zredlined/esp32-race-logger-enclosure/mechanical/reference/waveshare-7b/dimensions.md

# Waveshare ESP32-S3-Touch-LCD-7B (touch version) — measured from ESP32-S3-Touch-LCD-7B.stp, 2026-09-12

STEP frame: X = width (192.96), Z = height (110.76), Y = thickness, +Y toward the viewer. Glass face at Y = +0.8.

| Item | Value |
|---|---|
| Cover glass (lens OD) | 192.96 x 110.76, corners R7.88, X -96.48..96.48, Z -54.36..56.40 |
| Active area | 154.88 x 86.72 (long-edge borders 19.04 each; short-edge borders 11.00 and 13.04) |
| LCD metal frame (back) | 165.4 x 97.6, X -81.05..84.35, Z -46.42..51.18, back face at Y = -7.7 |
| Glass face to frame back | 8.5 (TP + LCD = 5.0) |
| PCB | 106.0 x 73.0 x 1.6, X -55.09..50.93, Z -46.22..26.79, Y -9.3..-7.7 (front face against frame back) |
| Tallest rear parts | terminal blocks 8.3 below PCB back (X 45.4..50.4, Z -23.0..23.9); total glass face to tallest part 18.4 |
| Mounting | 4 x M3 threaded lugs on the frame back, 15 x 8 mm pads, centers X -61.6 / +64.6, Z -32.8 / +32.9 (126.2 x 65.7 pattern); STEP shows the hole 1.7 deep but an M3 screw goes in about 3 mm (measured 2026-09-13) |
| PCB-to-frame screws | 4 x 4.3 mm holes at X -22.5 / 35.5, Z -27.0 / 22.1 (58.0 x 49.05); not for external use |
| USB-C | on the PCB -Z edge, X 10.3..19.3 (center 14.8), body 9 x 5.6 |
| PH2.0 / small headers on -Z edge | X -10.0..-3.9 and 1.1..7.2 |
| ESP32-S3 module | X -52.7..-34.7, Z -46.3..-20.8 (antenna at the -Z edge, -X corner) |

Source: https://www.waveshare.com/wiki/ESP32-S3-Touch-LCD-7B (drawing zip and schematic downloaded 2026-09-12).
