zredlined/esp32-race-logger-enclosure/docs/inspection-log.md

# Inspection log

## Pass 1 (2026-09-09), first full model in Onshape
Source: mechanical/generate_onshape.py -> Onshape Part Studio 1 (custom FeatureScript feature) -> STL -> mechanical/output/renders.
Clearance report: clean (plugs, cables, posts, standoffs, chute, ribs vs boards and each other). Cable table: C1 139/200, C2 73/100, C3 70/100 mm.

Found in renders and fixed in the generator:
- Saddle-to-sled inserts S1 (14,17) and S2 (60,62) sat inside the cradle block footprint, so the bores were buried and the inserts could never be installed. Moved to (27,13) and (W-4, 52.5), outside the block, still clear of cables and posts.
- SHT41 floor vent was blocked by the solid cradle block under the sled. Vent now passes through the plate and the block into the tube cavity.
- Section renders looked at the discarded side of the cut plane (render bug, not geometry).
- FeatureScript: `box` is a reserved word (compile error); the intersection op dropped body identity for the clamp cap (rebuilt with subtract + union).

Checked and OK: every through hole visible from both faces (sled bottom: 4 counterbored shell-screw holes, 2 saddle-screw holes, vent, 4 foot recesses; saddle bottom: 4 access holes, 2 insert bosses, 4 ear bores); flexure flaps 1.0 mm with 0.7 mm slots and 2.2 mm nubs; USB opening with 1 mm lead-in; IMU ledge and two snap hooks; cable ribs; posts clear of the stack; roof chamfer and 5 mm vertical fillets form one family; orange sled band is the only accent.

Open (documented, not fixed): reset button has no roof hole (it would merge with the window edge; shell off in 4 screws); microSD card end sits ~4 mm inside the wall (user says SD access is optional).

## Pass 2 (2026-09-09), Gate C panel (industrial design, FDM, wiring/RF/thermal, red team) on the pass-1 renders
Blocks found and fixed: saddle S1/S2 bores did not pass through the plate (now bored from the plate top); shell and cap screws bottomed in 5 mm bores before the heads seated (post bores 7.5, ear bores 9.0); post P3's screw sat 5 mm above the roll bar (P3 is now a bearing pad, 3 shell screws); key-bar 0.5 mm top recess was an overhang on the bed face and adjacent slots had 0.05 mm slivers (flaps now flush, 0.6 mm thick, 10 mm long, 0.8 mm slots, nub gap 0.1); forward chevron pointed backward on roof and sled (rotation sign).
Fix-before-print applied: louver tops on the SD slot datum (5 + 4 slots, plus 3 back-wall chimney slots over the ESP32); SHT41 vent moved beside the cradle block so it reaches free air; clamp bore 0.3 under the liner radius with cap flanges 1 mm open (real preload); C1 dives to the floor after its corner and runs in an 8 mm wall channel, middle-lane channel rib 8 mm; chute 0.3 from the wall, back margin +0.5 for post P4; pilot holes 2.2 / 1.75, 1.5 mm deeper; IMU hook lips 1.2 mm overlap at +0.05; window inner pocket for a 1 mm PC sheet; reset pin hole; 1.5 mm radii on USB/SD openings; saddle plate inset to the shell footprint (orange band is the outermost lower edge); cradle and cap 5 mm fillets; sled and saddle 0.5 mm bed chamfers; GPS square aligned to the window edge; A/B/C dots; nylon M2 screws at the Feather antenna end (hardware note); test coupon part added.
Deferred: round two-ear collar instead of the block cradle (ID nice-to-have); SD thumb scallop; tie-down bridges (channels + glue instead); satellite glyph.
Pass-2 renders read clean: through holes visible both faces, no slivers, flaps and nubs correct, louvers on one datum, chevron forward.

## Pass 3 (2026-09-09): added the blanked drop slot for a future analog bay and the Universal base (GoPro 3-finger) as the v1 mount. Clearance clean. Renders checked: fingers round-ended and centred, strap slots clear of access holes and inserts.

## Pass 4 (2026-09-11): the "floating GoPro mount"
The user saw the base fingers floating in Onshape. Cause: fingers, cradle and insert bosses overlapped their plates by only 0.01 mm, and Onshape did not fuse them, so the base and saddle each exported as two bodies. Fix: 1.0 mm overlap into the plate. The exporter now loads each STL and fails unless it is one manifold body. All six parts pass.

## Pass 5 (2026-09-12): stack height corrected from hardware
User measured 27.0 mm from the Feather PCB bottom to the OLED PCB top with the real 2830 stacking headers (6.9 mm body, 11.4 mm tails, 12.7 mm pitch per level). The model assumed 8.5 mm sockets (21.7 mm). STACK_PITCH = 12.7 added; everything above the Feather re-derives: interior height 29.3 -> 34.6, roof top 36.6, SD slot z 16.3-22.3, louver tops on the new SD datum, chimney slots 22.3-32.1, OLED QT exit 26.4-29.4, key nubs and window follow. Clearance clean. Note added: trim the Feather's bottom header tails to <= 3 mm.

## Pass 6 (2026-09-12): coupon results applied
Insert bore 3.4 (tight, melted flush, no gaps under magnification; 3.6 marginal; 3.8 fell in). M2.5 self-tap best in 2.4 (2.2 too tight). Keys: all three click the OLED Wing buttons, slots printed open. M2 not tested (no screws on hand); pilot scaled to 1.9. Constants updated, regenerated, assemblies rebuilt, STLs re-exported (all one manifold body).

## Pass 7 (2026-09-12): button cap height measured
User measured 4.0 mm from the OLED Wing PCB bottom to the button cap top (2.43 above PCB top; model had 1.9). With the old value the key nubs would have held the buttons half-pressed. Z_BTN_TOP now derives from the measurement; nubs are 2.55 mm tall, 0.1 above the caps; caps clear the roof underside by 1.2 mm. Shell re-exported (one manifold body), assemblies rebuilt. Base and sled unchanged.

## Pass 8 (2026-09-12): stack tolerance
Assembled stack eyeballed at just under 30 mm Feather-PCB-bottom to cap top vs 29.4 from summed measurements. Design now uses 29.7 with 0.3 mm nub clearance (covers 29.4 to 30.0 without pre-pressing) and the roof underside at glass + 2.1 (35.1) so a tall stack keeps >= 1 mm over the caps. Nubs 2.25 mm. Shell re-exported; base and sled unchanged. If keys feel pre-pressed after assembly, sand the nubs; if dead, a dot of glue on the nub tip.

## Pass 9 (2026-09-13): first assembled prototype feedback
User assembled v1. Findings and fixes: IMU hook lips printed flush with the PCB top (0.05 design gap) so the board could not wedge under; lips now 0.35 above the PCB with a 0.7 mm 45-degree lead-in and taller posts. Keys work well. Reset pin hole replaced by a round flexure key (r 1.9, stem toward the back wall, own 1.8 mm nub on the reset switch), visually distinct from the three pills; its ring slot merges into key C's slot, 0.77 mm web to the window. A/B/C dots enlarged to 1.2 mm (0.9 read as print defects); the layer-3 filament change fills all roof engravings orange. Window right edge pulled in 2.5 mm (GLASS_TRIM_R): the real glass ends before the STEP model's edge and bare PCB showed. GPS lifted onto four 7 mm pillars, deck at z 26: patch top 34.0, 1.1 under the roof and above the stack's 33 mm shadow; C1 now runs level (113 mm), C2 descends through the middle-lane U (66 mm). Visible roof-to-glass gap around the window: recommended a 1 mm smoked PC lens in the existing inner pocket rather than a bezel lip (header solder sits 0.8 mm from the glass on the long edges). Analog bay untouched pending the conditioning circuit.

## Pass 10 (2026-09-13): control-field frame
Reset key stem now points -X so all four keys hinge on one line. Added a 0.8 x 0.4 mm rounded-rectangle groove (r 2.5) framing dots, keys and window, 1.8 mm outside the window and reset ring; all webs >= 1 mm; fills orange with the layer-3 colour change. Shell re-exported.

## Pass 11 (2026-09-13): roof graphics study
Rendered five arrangements of frame / 4OGS wordmark / GPS mark (variant_*.png): A frame + 36 mm logo beside a 22 mm GPS square (two rectangles compete at one height); B same without the frame (key slots read as unresolved); C/C2 12 mm GPS glyph over the actual patch + 34-40 mm logo on the roof (better hierarchy, still a heavy roof); D small corner logo on the chevron baseline (too small for FDM slits, crowds the chevron); E roof = frame + 12 mm GPS glyph + chevron, 32 mm 4OGS wordmark engraved 0.4 deep on the back wall facing the driver. Recommended and set as default: E. The wordmark uses only the seven "4OGS" polygons from reference/4ogs_logo.svg; RACING text and outline are too thin to print. Wall engraving stays graphite (no bed-face colour trick); optional slicer paint if orange is wanted.
- Print palette: dark gray body, purple accent (4OGS livery), layer 3-4 change on the shell.

## Pass 12 (2026-09-13): insert bores
On real parts the 3.4 mm bore (coupon pick) would not pass the insert's base flange; posts and the 3 mm plate cannot absorb 0.6 mm of displaced plastic. Bores now 3.6 with a 4.0 x 0.8 mm seat at the mouth (shell posts, base and saddle bosses, cradle ears). Parts already printed at 3.4: ream with a 3.6 mm (9/64 in) drill before heat-setting.

Correction (same day): the user's inserts are M2.5 x 4 x 3.5 OD (and M2 x 4 x 3.2 OD, unused). A 3.4 bore is correct for a 3.5 OD insert; cold non-fit of the body is expected. Reverted to 3.4 with a 3.6 x 0.5 mm lead-in; no reaming needed on printed parts.

## Pass 13 (2026-10-02): v2 analog tray
Added the tray, two connector cards and the ADS riser frame to the generator (`tray_envelopes()` / `tray_validate()` run with the box check). Findings fixed before the first export: the ADS stack's rear plug housing was 0.35 mm from the S2 column (stack moved 1 mm forward, now 1.9 mm); a proto support pad overlapped the P4 block (pads inset 3.6 mm); the riser frame exported as two bodies (its two edge bars did not meet; bars moved to the sleeve tops with a mid-board cross bar 4 mm above the lower board's parts). Known conservative flags replaced by explicit margin checks: the 6.6 mm wide plug envelopes clip the S2 / P2 columns in plan although the housings end 1.9 / 4.8 mm short of them and the 1.5 mm cable runs 0.9 mm inside the column faces; the SHT41 rear plug envelope clips the shell's P3 pad by 0.6 mm (real housing 3 mm short, C4 turns toward the drop slot). Cable budget: C4 route 56 mm on a 100 mm cable; the 50 mm hairpin needs 40 mm of wire and loops to 6.7 mm from the card. Not yet verified on a print: the horizontal 2.4 mm card-screw pilots, the proto hooks on 1.6 mm FR4 (same geometry as the IMU hooks that work), and the real M12 body length behind the card.

Pass 13b (2026-10-02, before printing): the ADS stack screw was specified as M2.5 x 16 but the stack (9.1 mm) plus the 6 mm pilot only takes 15.1 mm: changed to M2.5 x 14 (4.9 mm engagement) and added a screw-length check. The 5 mm ADS standoffs left 1.3 mm of wall around the 2.4 mm pilot, thin enough to split when self-tapping: now 6 mm, D-shaped with a flat 0.4 mm from the proto edge (1.54 mm wall) on the proto side and fused to the right wall on the other. Local only; the tray STL on disk predates this and must not be printed.

Pass 13c (2026-10-02): the user will not buy screws (kit: M2.5 x 4-8, 10, 12, 16, 20, 25). Fastening re-plumbed so nothing is bought: shell screws M2.5 x 25 with their heads seated 7 mm up inside the tray's P columns (5.2 mm driver channel from the tray bottom, 4.8 mm of thread in the shell inserts); sled to tray by M2.5 x 8 into two inserts in the S column tops; tray to base by M2.5 x 10 from below through the base's inserts (blind bores drilled through 2.7 mm) into 5.5 mm pilots; ADS stack M2.5 x 16 with the lower standoffs raised to 6.5 mm (8 mm pilot, 6.9 mm engaged). Tray height is now set by the ADS stack: 23.5 mm. The screw-length checks in tray_validate() cover all four joints. Local only, not pushed.

Pass 13d (2026-10-02, exported): first push of the 23.5 mm tray failed to regenerate. Cause: the 5.2 mm driver channel at P4 was exactly tangent to the corner block's inner face (x 6.6); Parasolid rejects coincident tangent faces. Fix: channel 5.0 (the diameter the v1 counterbores already use for these heads), P4 block face at 7.0, proto board at x 7.3 (0.3 from the block, 0.5 from the ADS stack), 0.5 mm relief in the right wall beside the stack (0.7 mm board-to-wall). A tangency check is now part of tray_validate(). The generator also gained a CadQuery mirror (`--local`) so renders and fit checks no longer need Onshape; only the printable export does. Exported and verified single manifold bodies: analog_tray, connector_card_(2x_m12), connector_card_(blank), ads_riser_frame. The Onshape 'Enclosure v2' assembly still shows the 21.5 mm version (rebuild deferred to save API calls).
