zredlined/esp32-race-logger-enclosure/docs/concepts/A_slab_front.png

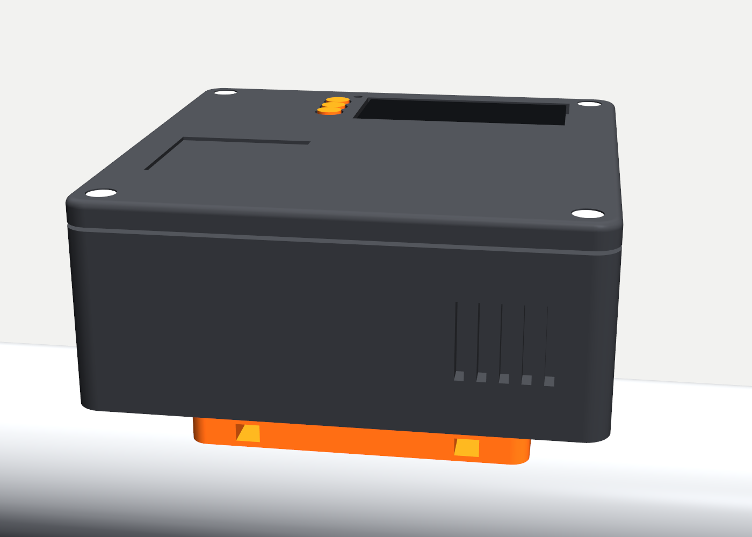
docs/concepts/A_slab_front.png
