zredlined/esp32-race-logger-enclosure/docs/concepts/A_slab_iso.png

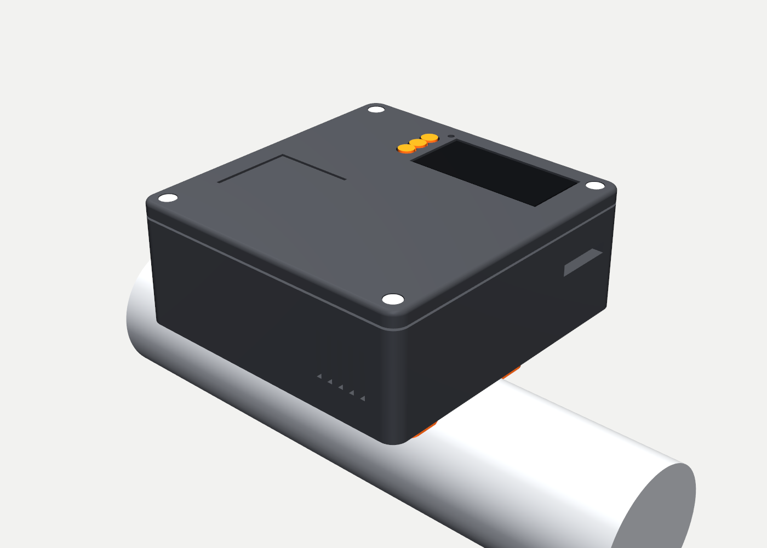
docs/concepts/A_slab_iso.png
