zredlined/esp32-race-logger-enclosure/docs/concepts/C_wedge_front.png

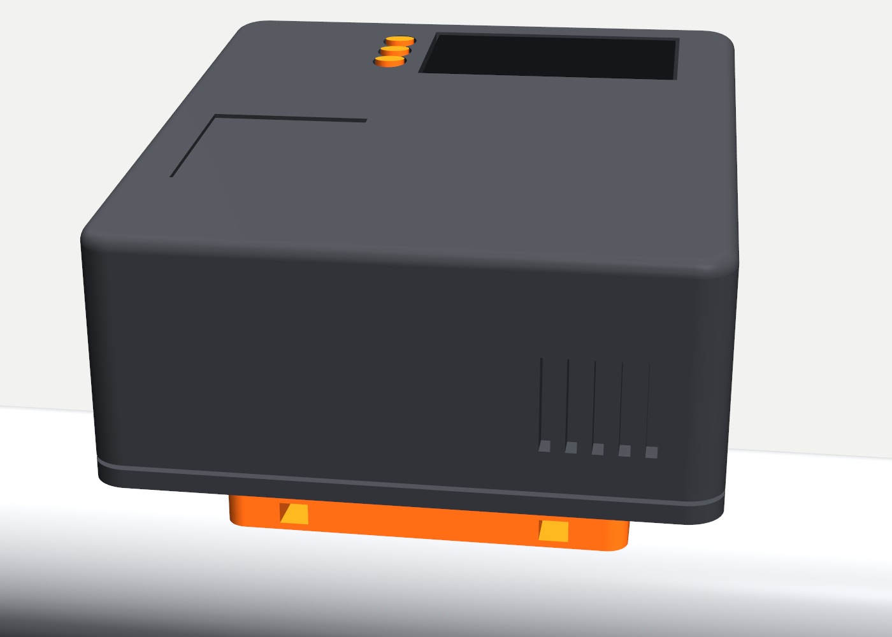
docs/concepts/C_wedge_front.png
