zredlined/esp32-race-logger-enclosure/docs/concepts/C_wedge_iso.png

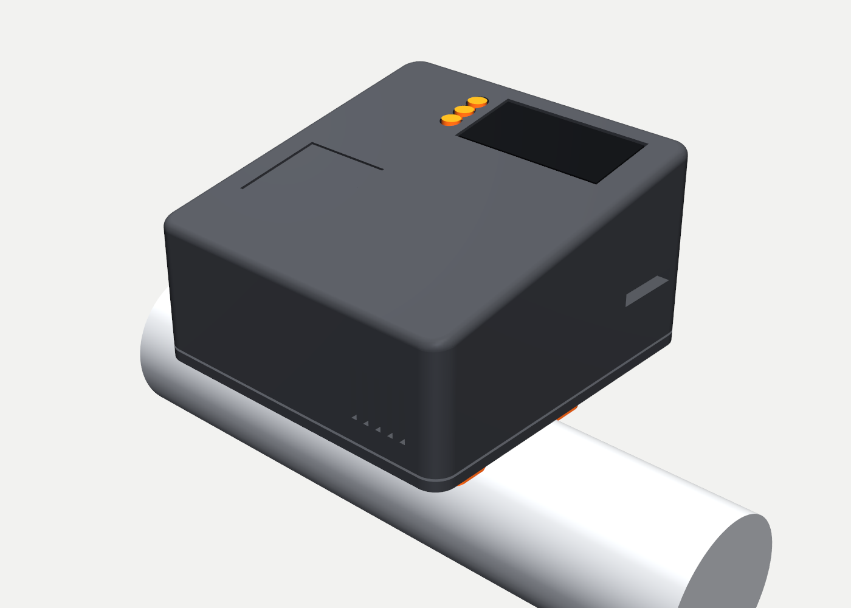
docs/concepts/C_wedge_iso.png
