zredlined/esp32-race-logger-enclosure/docs/concepts/layout_top.png

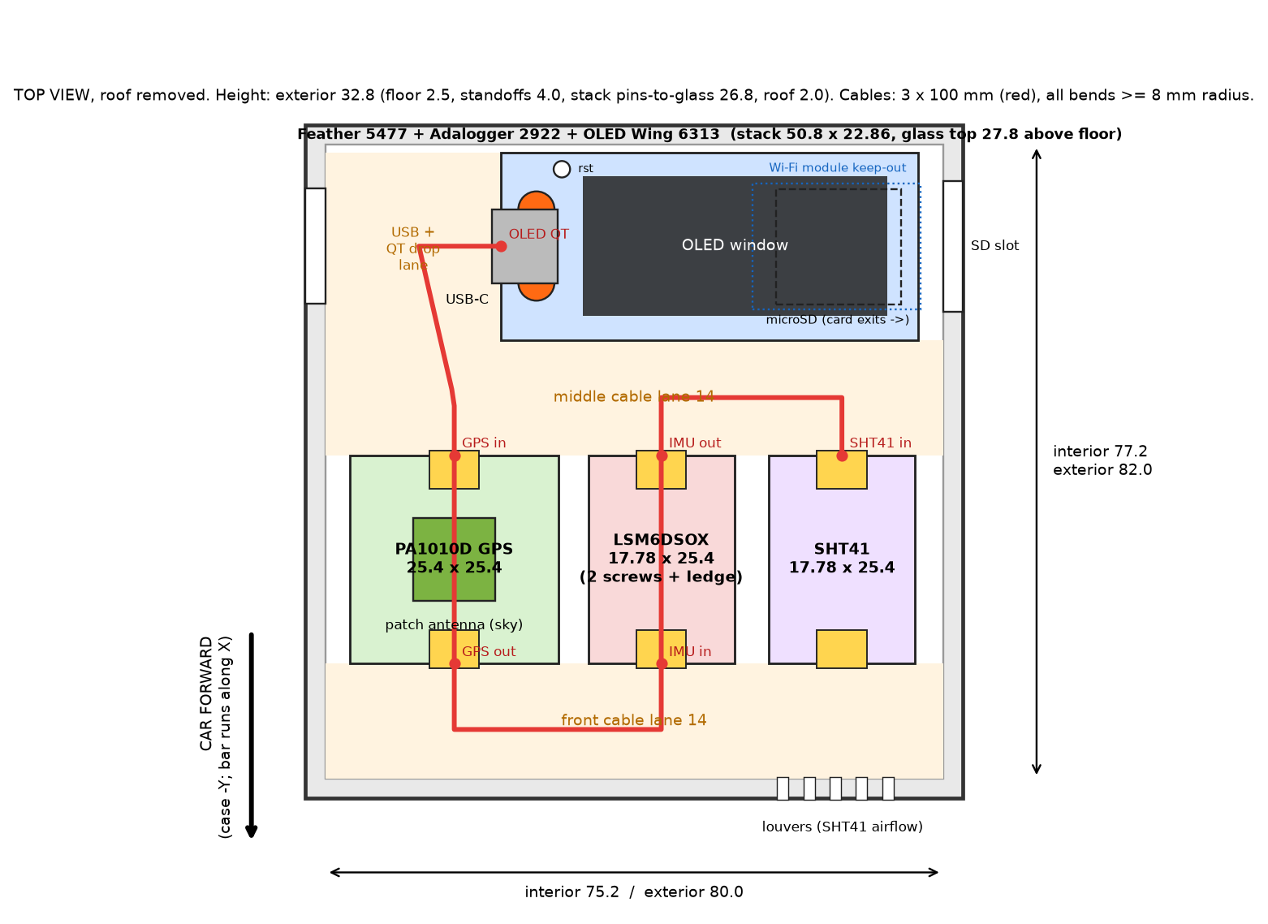
docs/concepts/layout_top.png
