zredlined/esp32-race-logger-enclosure/mechanical/display/output/renders/asm_back.png

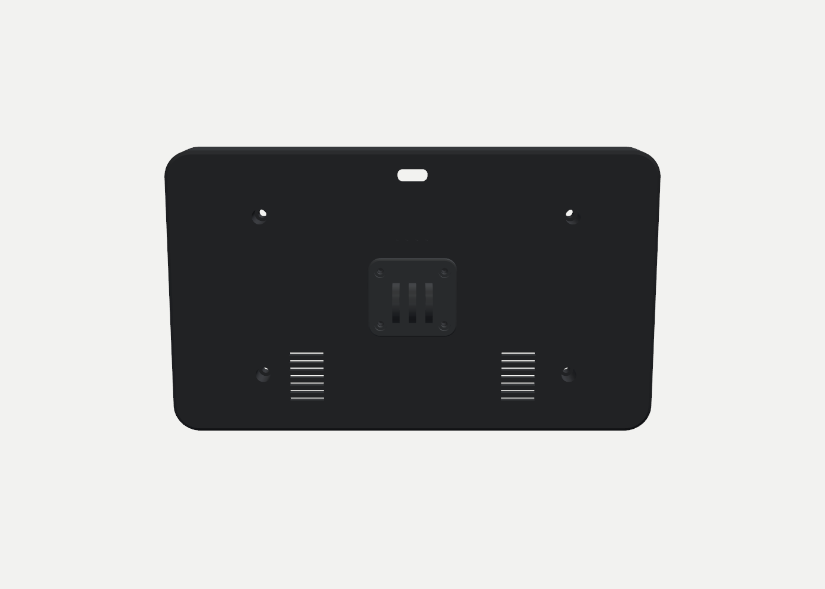
mechanical/display/output/renders/asm_back.png
