zredlined/esp32-race-logger-enclosure/mechanical/display/output/renders/asm_back_iso.png

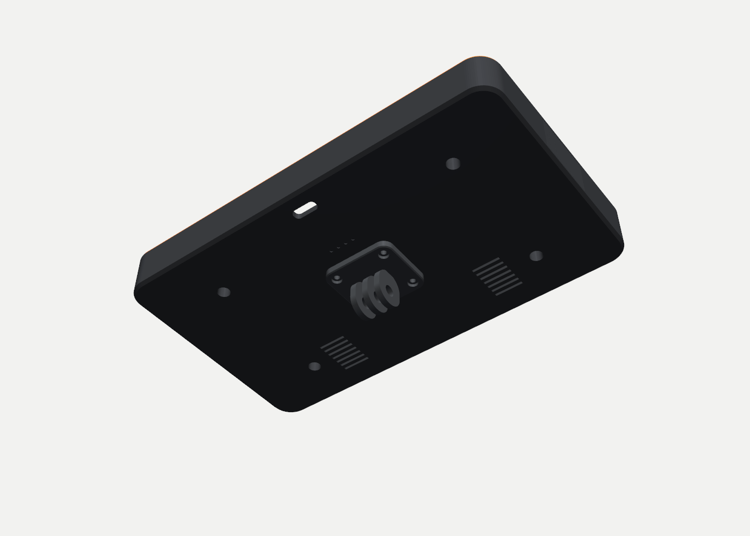
mechanical/display/output/renders/asm_back_iso.png
