zredlined/esp32-race-logger-enclosure/mechanical/display/output/renders/asm_front.png

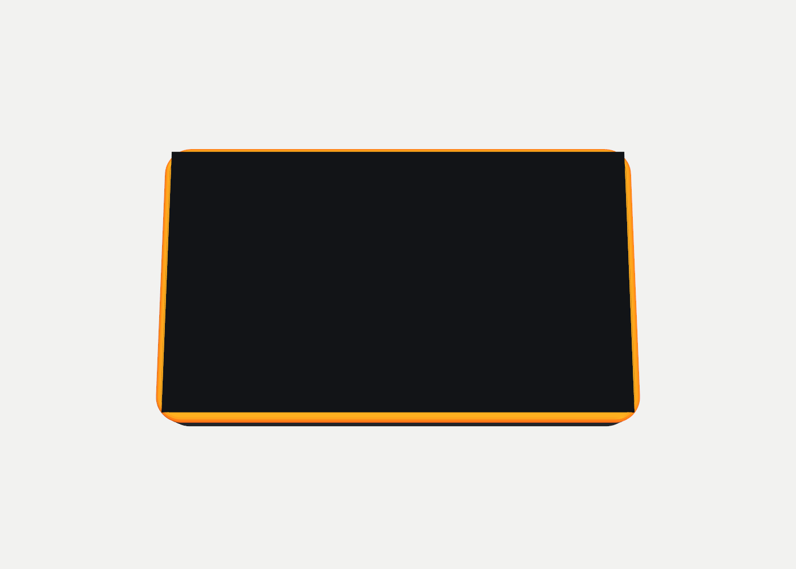
mechanical/display/output/renders/asm_front.png
