zredlined/esp32-race-logger-enclosure/mechanical/display/output/renders/asm_front_iso.png

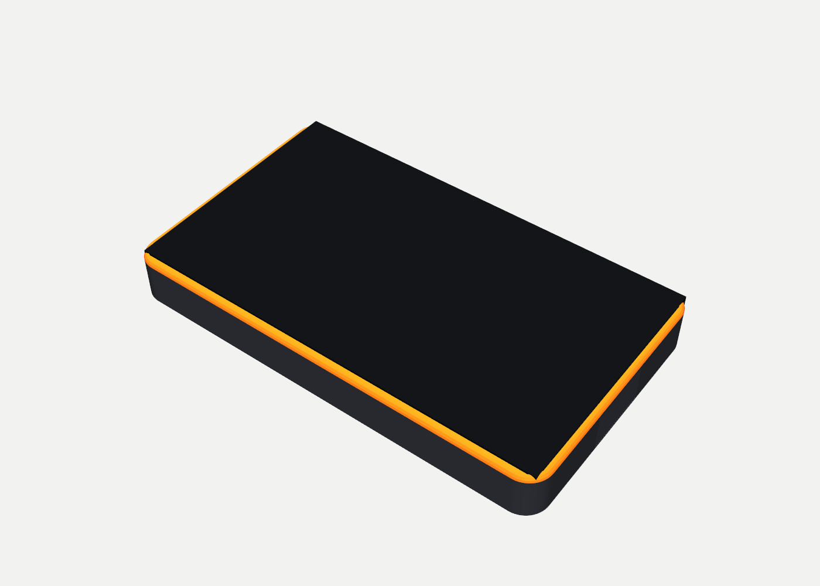
mechanical/display/output/renders/asm_front_iso.png
