zredlined/esp32-race-logger-enclosure/mechanical/display/output/renders/asm_section_boss.png

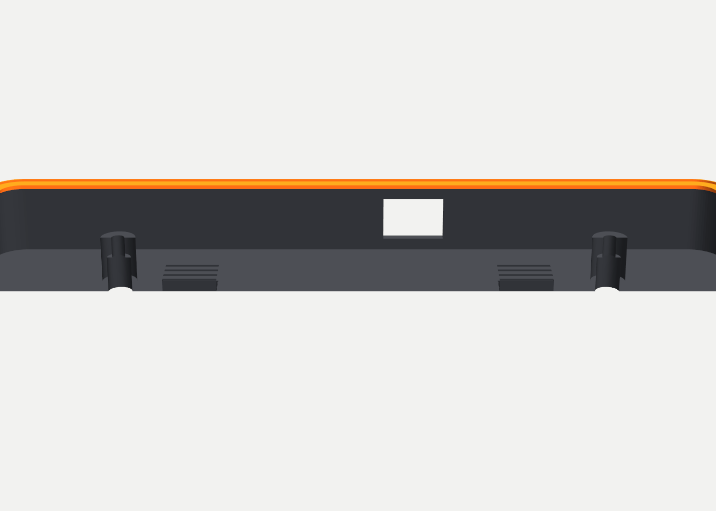
mechanical/display/output/renders/asm_section_boss.png
