zredlined/esp32-race-logger-enclosure/mechanical/display/output/renders/asm_section_usb.png

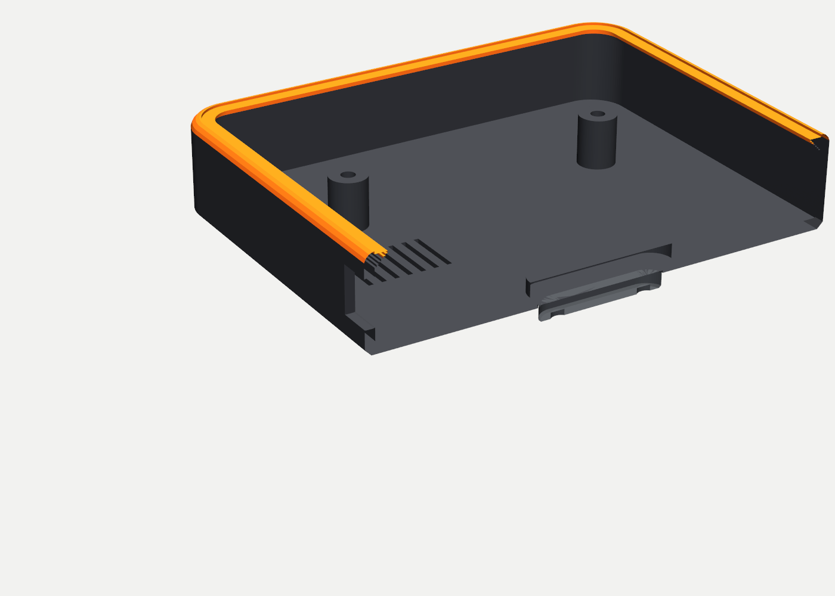
mechanical/display/output/renders/asm_section_usb.png
