zredlined/esp32-race-logger-enclosure/mechanical/display/output/renders/asm_top_edge.png

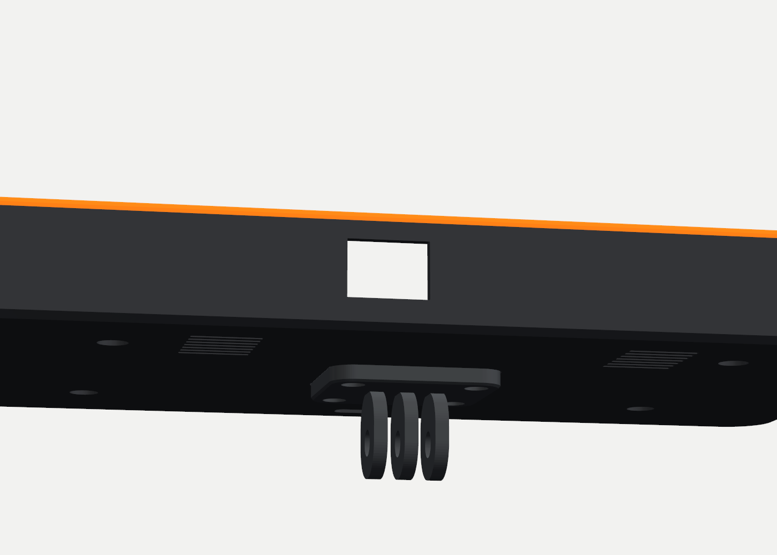
mechanical/display/output/renders/asm_top_edge.png
