zredlined/esp32-race-logger-enclosure/mechanical/display/output/renders/backpack_bottom.png

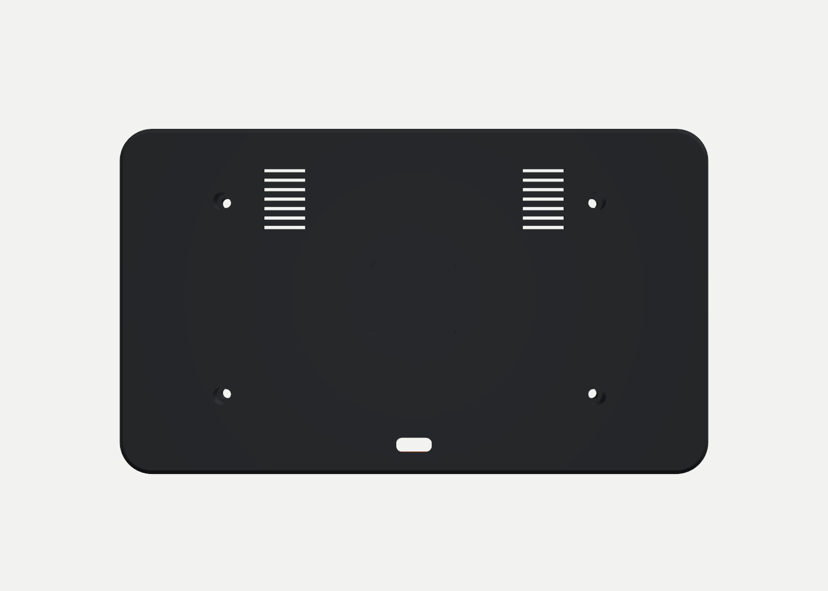
mechanical/display/output/renders/backpack_bottom.png
