zredlined/esp32-race-logger-enclosure/mechanical/display/output/renders/backpack_front.png

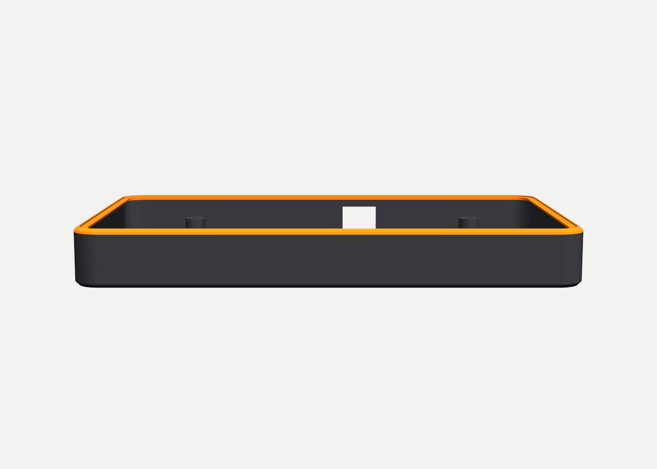
mechanical/display/output/renders/backpack_front.png
