zredlined/esp32-race-logger-enclosure/mechanical/display/output/renders/backpack_iso.png

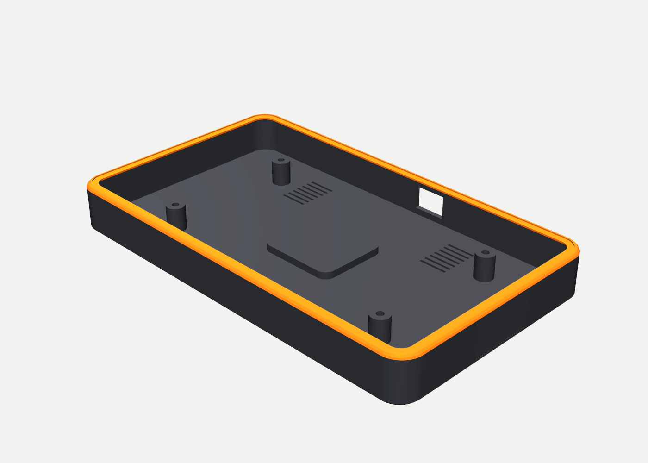
mechanical/display/output/renders/backpack_iso.png
