zredlined/esp32-race-logger-enclosure/mechanical/display/output/renders/backpack_iso_back2.png

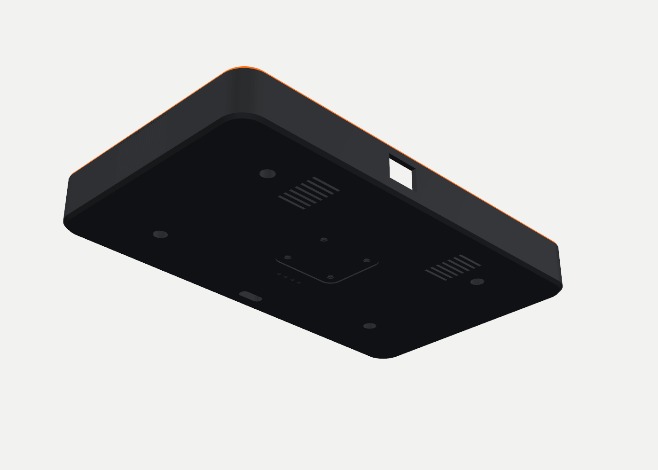
mechanical/display/output/renders/backpack_iso_back2.png
