zredlined/esp32-race-logger-enclosure/mechanical/display/output/renders/backpack_right.png

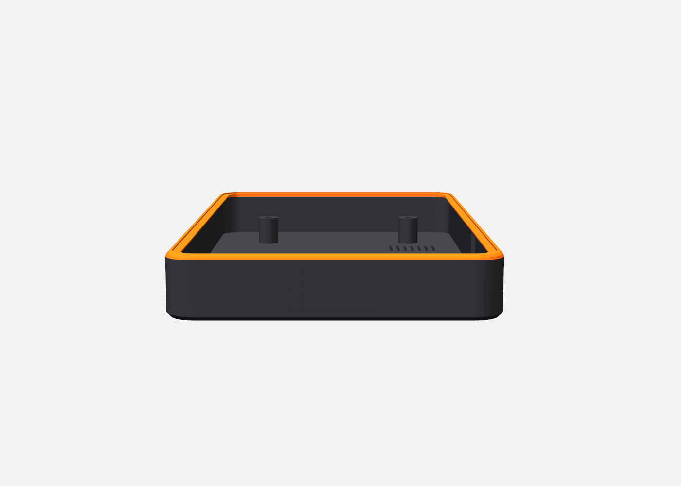
mechanical/display/output/renders/backpack_right.png
