zredlined/esp32-race-logger-enclosure/mechanical/display/output/renders/bench_stand_bottom.png

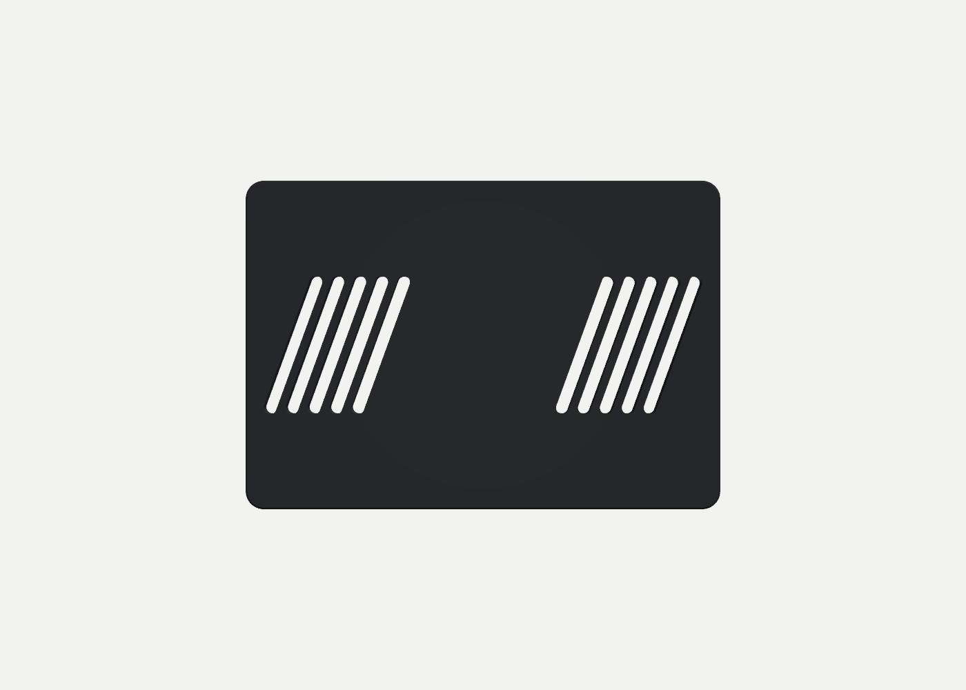
mechanical/display/output/renders/bench_stand_bottom.png
