zredlined/esp32-race-logger-enclosure/mechanical/display/output/renders/bench_stand_front.png

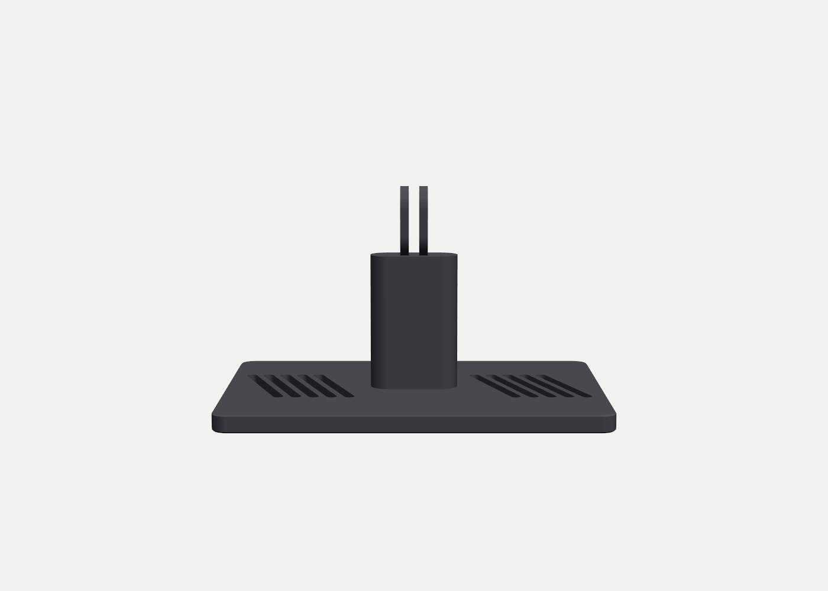
mechanical/display/output/renders/bench_stand_front.png
