zredlined/esp32-race-logger-enclosure/mechanical/display/output/renders/bench_stand_iso.png

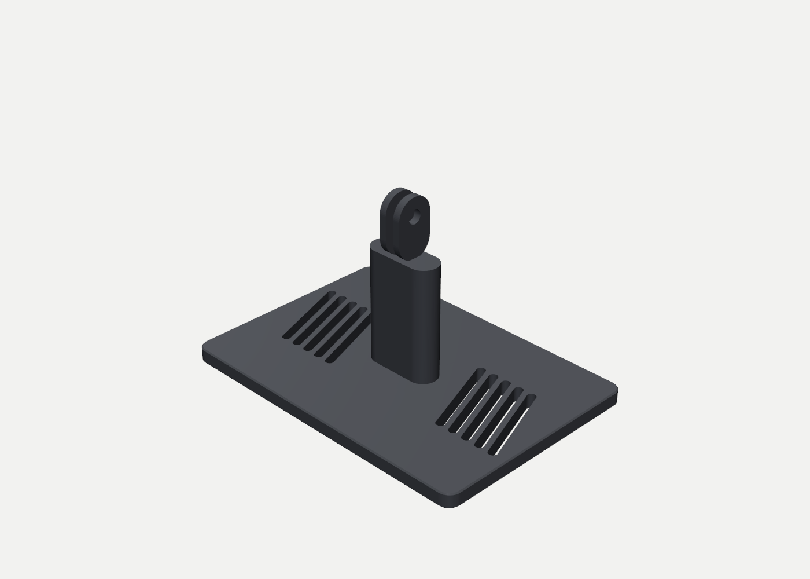
mechanical/display/output/renders/bench_stand_iso.png
