zredlined/esp32-race-logger-enclosure/mechanical/display/output/renders/crown_corner_zoom.png

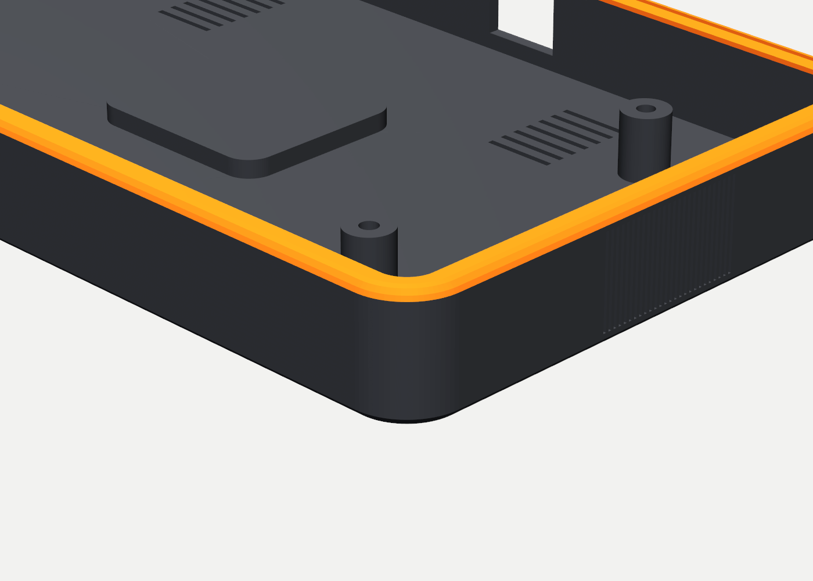
mechanical/display/output/renders/crown_corner_zoom.png
