zredlined/esp32-race-logger-enclosure/mechanical/display/output/renders/gopro_puck_bottom.png

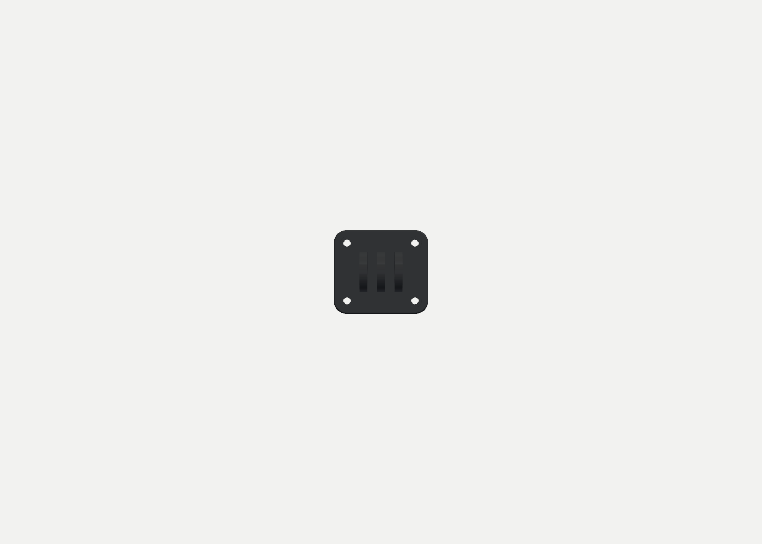
mechanical/display/output/renders/gopro_puck_bottom.png
