zredlined/esp32-race-logger-enclosure/mechanical/display/output/renders/ledge_section.png

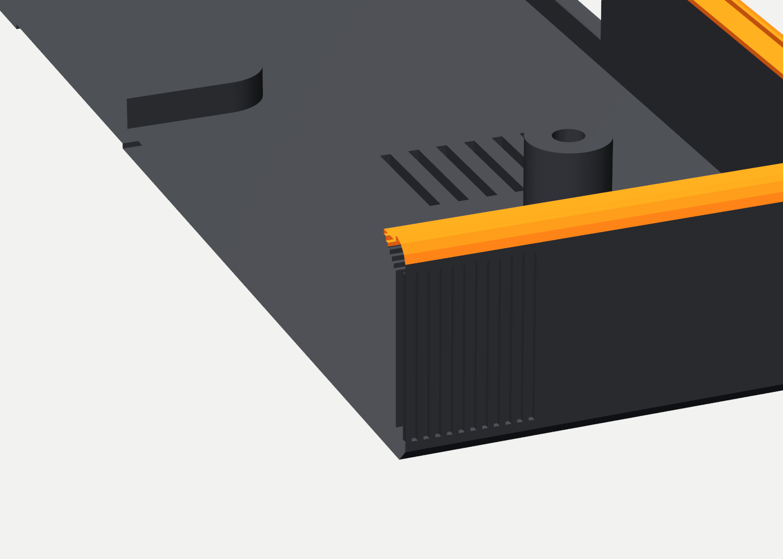
mechanical/display/output/renders/ledge_section.png
