zredlined/esp32-race-logger-enclosure/mechanical/display/output/renders/louver_zoom.png

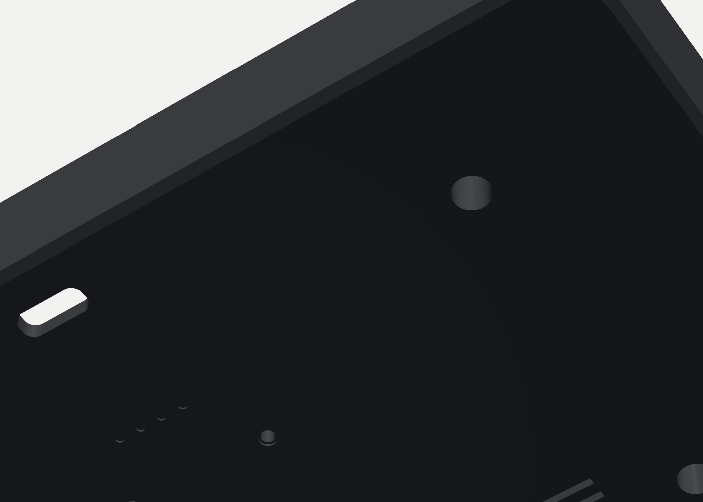
mechanical/display/output/renders/louver_zoom.png
