zredlined/esp32-race-logger-enclosure/mechanical/display/output/renders/onshape_asm_bottom.png

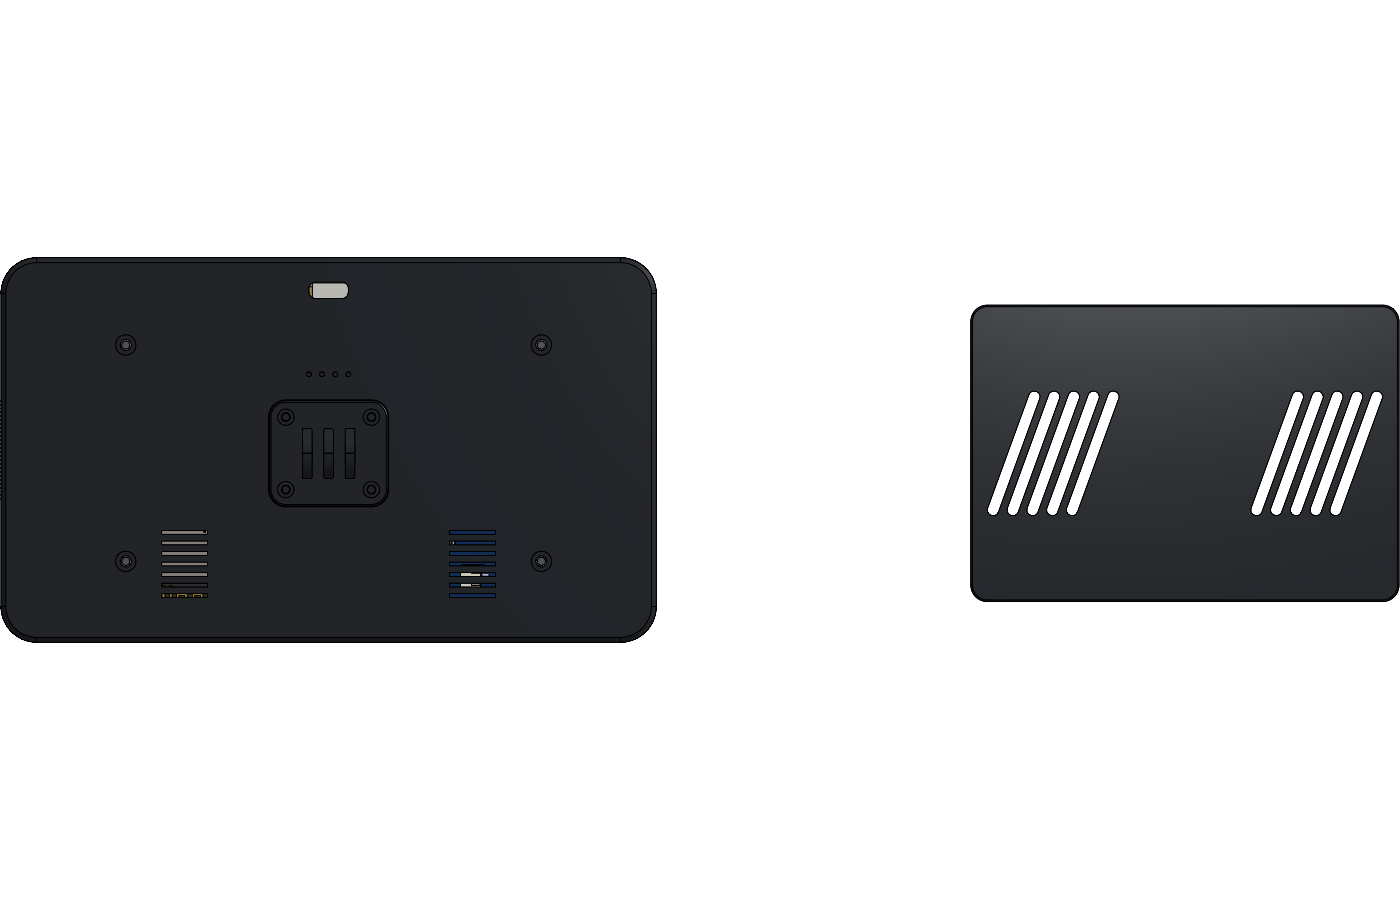
mechanical/display/output/renders/onshape_asm_bottom.png
