zredlined/esp32-race-logger-enclosure/mechanical/display/output/renders/onshape_asm_front.png

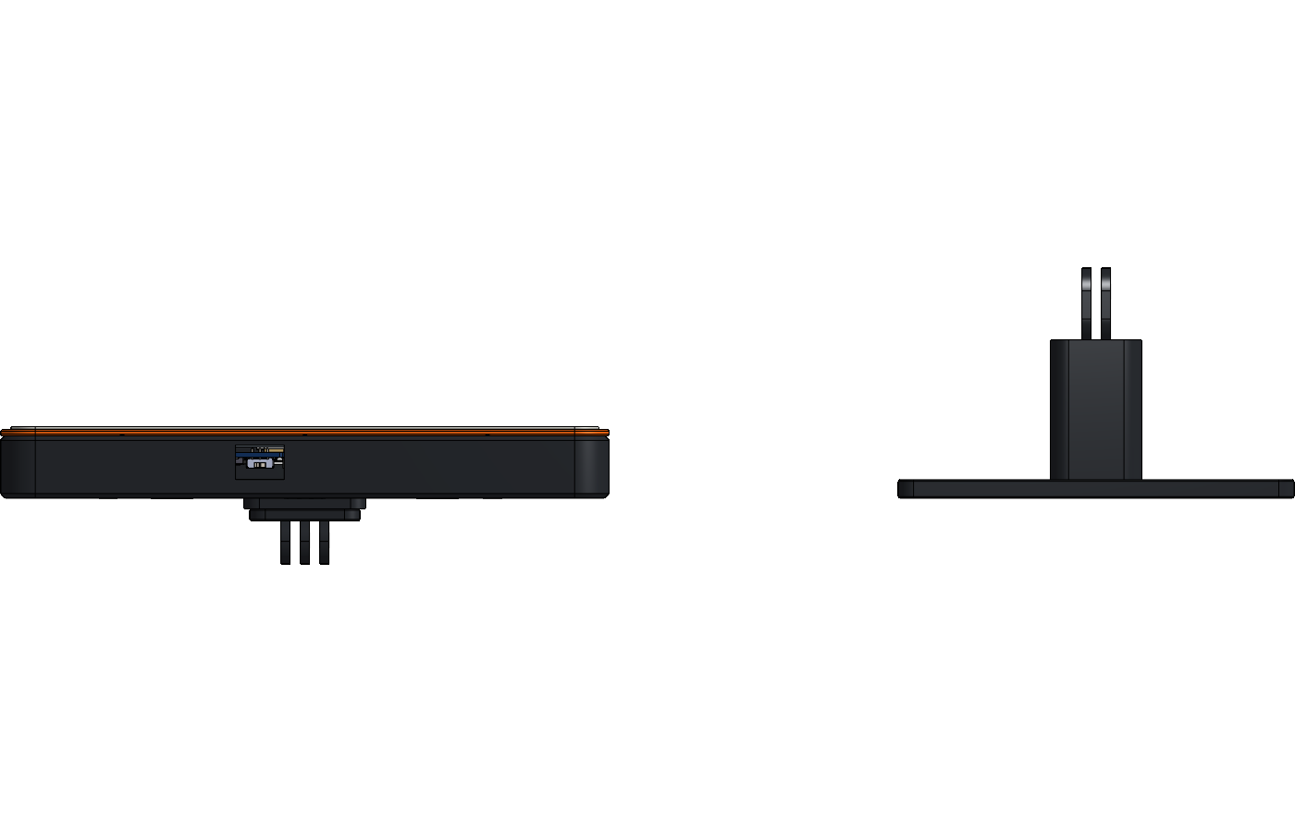
mechanical/display/output/renders/onshape_asm_front.png
