zredlined/esp32-race-logger-enclosure/mechanical/display/output/renders/onshape_asm_iso.png

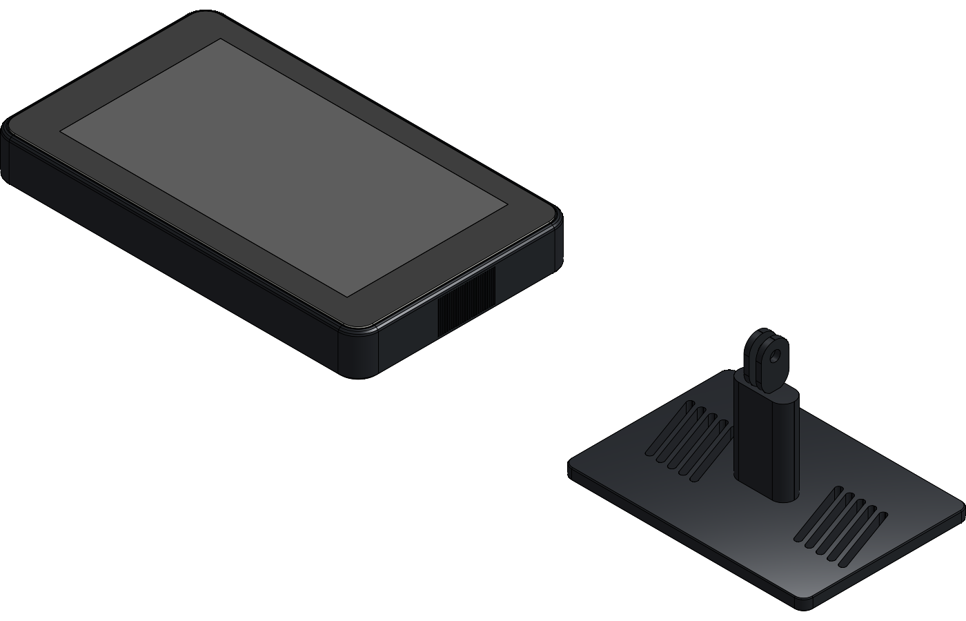
mechanical/display/output/renders/onshape_asm_iso.png
