zredlined/esp32-race-logger-enclosure/mechanical/display/output/renders/plateau_zoom.png

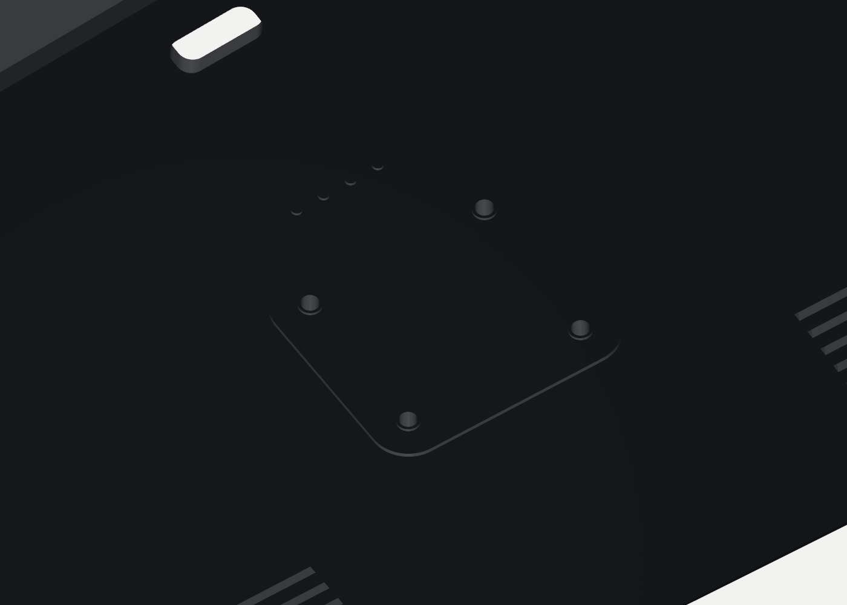
mechanical/display/output/renders/plateau_zoom.png
