zredlined/esp32-race-logger-enclosure/mechanical/display/output/renders/recess_zoom.png

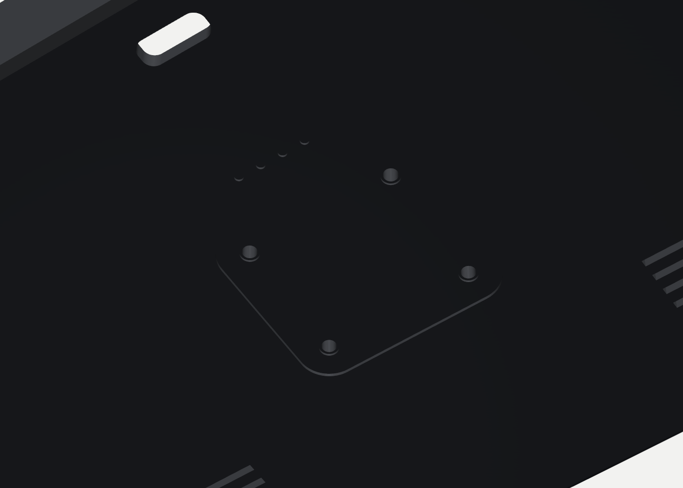
mechanical/display/output/renders/recess_zoom.png
