zredlined/esp32-race-logger-enclosure/mechanical/display/output/renders/rib_zoom.png

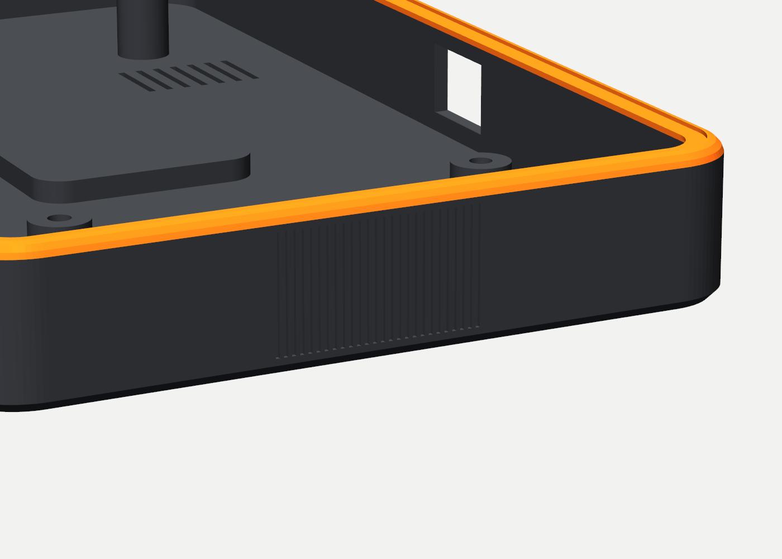
mechanical/display/output/renders/rib_zoom.png
