zredlined/esp32-race-logger-enclosure/mechanical/display/output/renders/stand_top.png

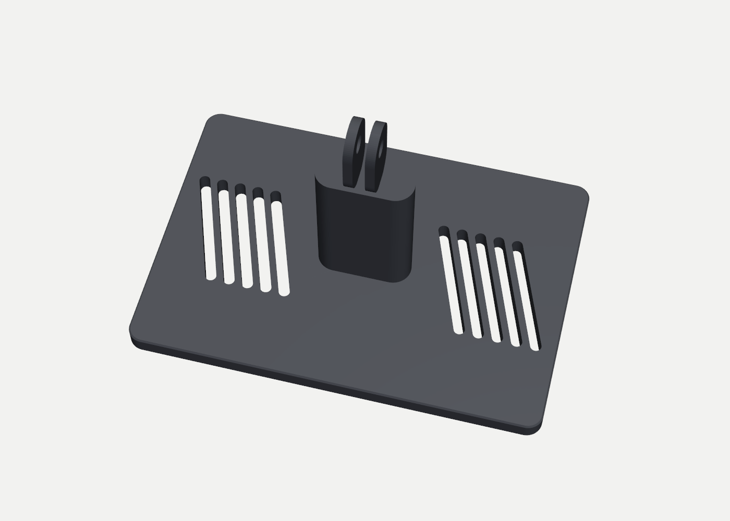
mechanical/display/output/renders/stand_top.png
