zredlined/esp32-race-logger-enclosure/mechanical/output/layout.png

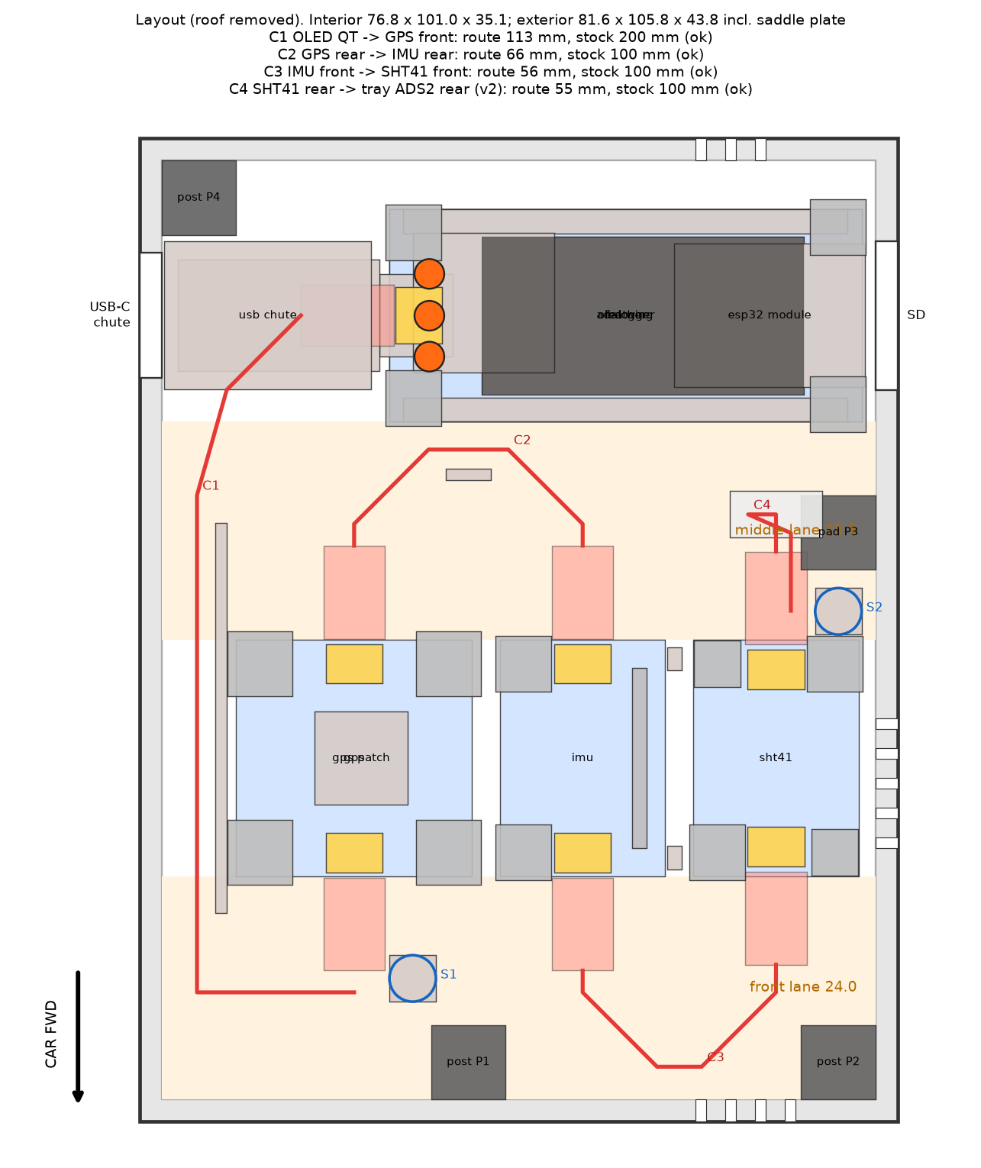
mechanical/output/layout.png
