zredlined/esp32-race-logger-enclosure/mechanical/output/renders/base_bottom_zoom.png

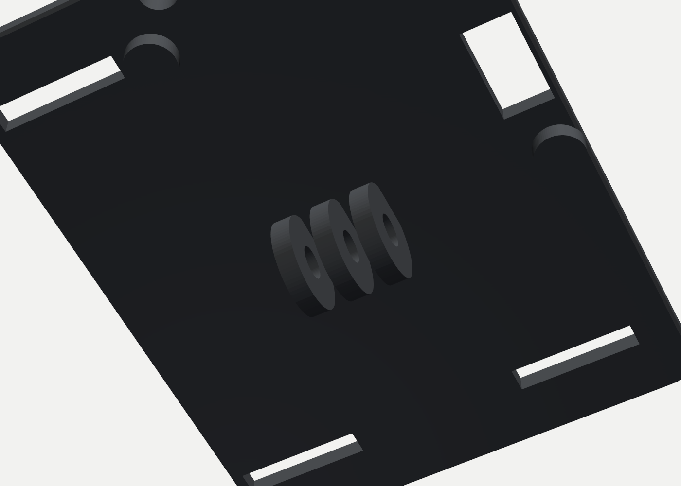
mechanical/output/renders/base_bottom_zoom.png
