zredlined/esp32-race-logger-enclosure/mechanical/output/renders/card_back_iso.png

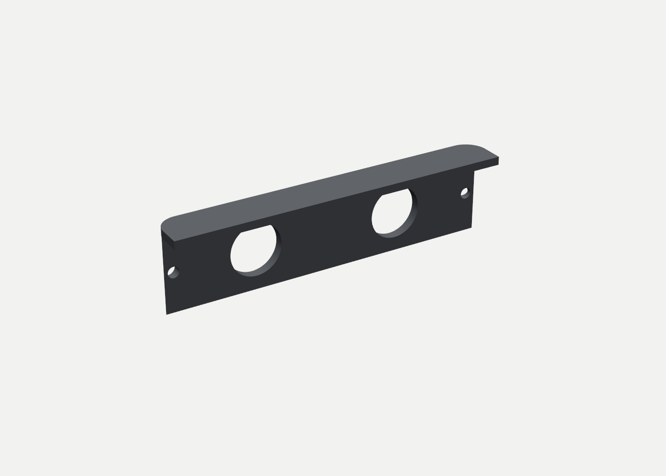
mechanical/output/renders/card_back_iso.png
