zredlined/esp32-race-logger-enclosure/mechanical/output/renders/card_front.png

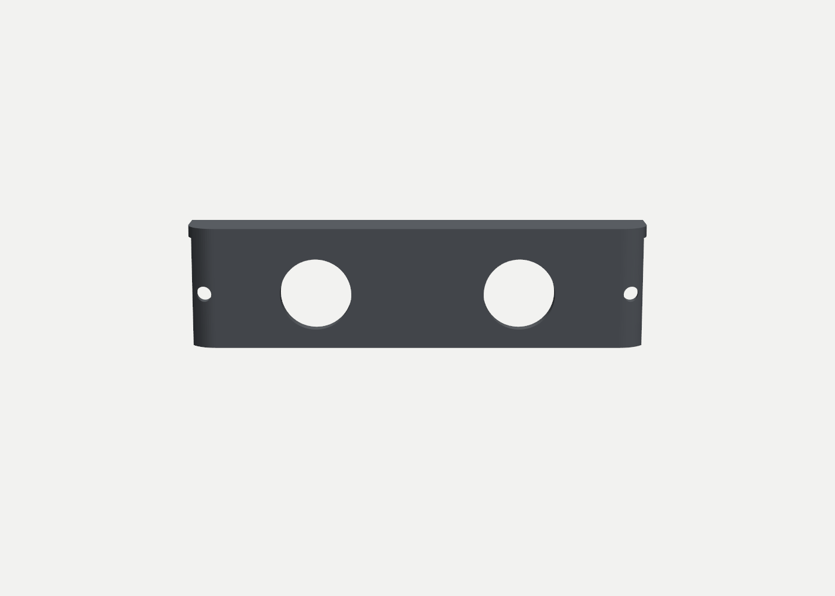
mechanical/output/renders/card_front.png
