zredlined/esp32-race-logger-enclosure/mechanical/output/renders/clamp_cap_front.png

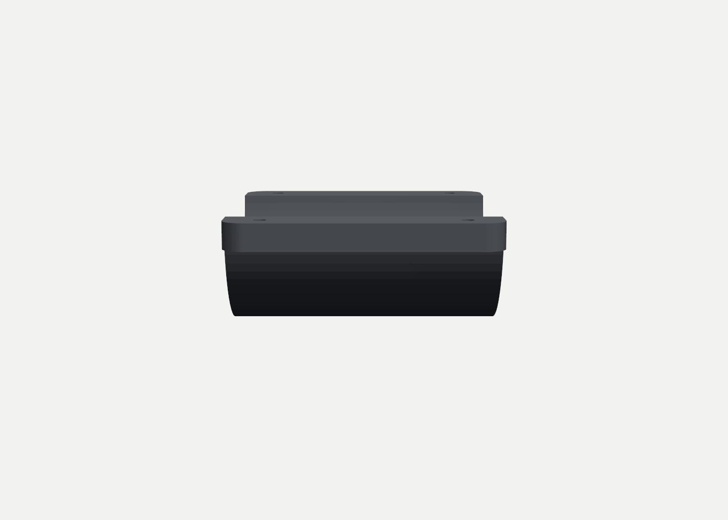
mechanical/output/renders/clamp_cap_front.png
