zredlined/esp32-race-logger-enclosure/mechanical/output/renders/clamp_cap_iso.png

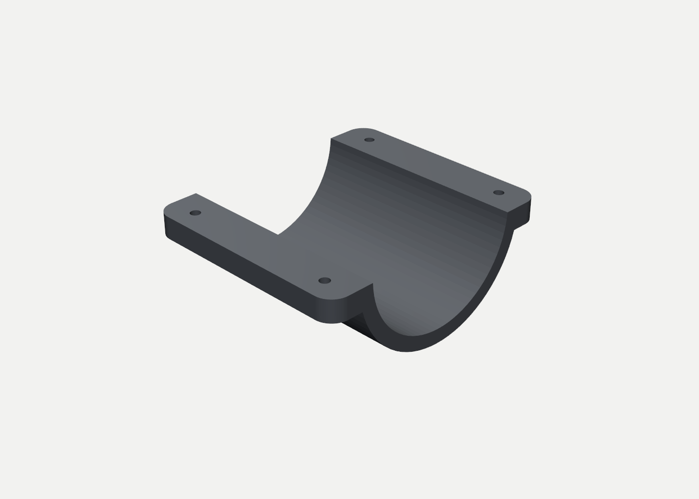
mechanical/output/renders/clamp_cap_iso.png
