zredlined/esp32-race-logger-enclosure/mechanical/output/renders/clamp_cap_right.png

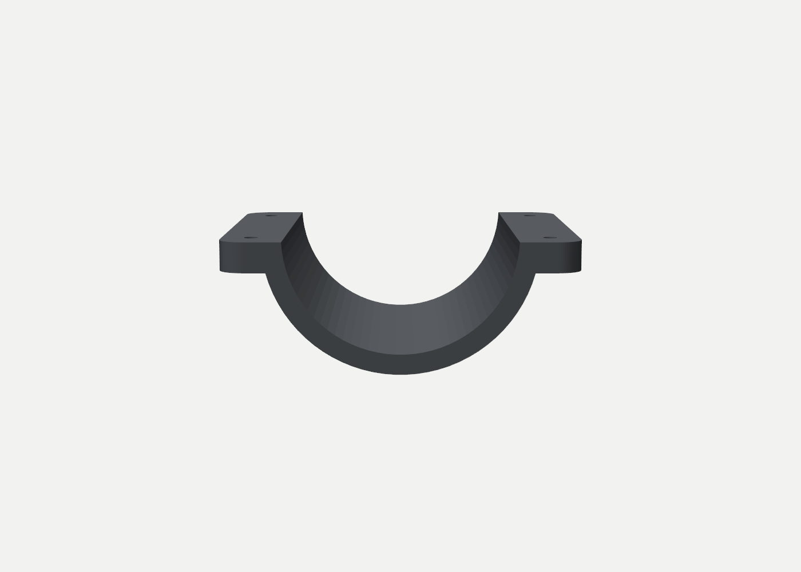
mechanical/output/renders/clamp_cap_right.png
