zredlined/esp32-race-logger-enclosure/mechanical/output/renders/clamp_cap_top.png

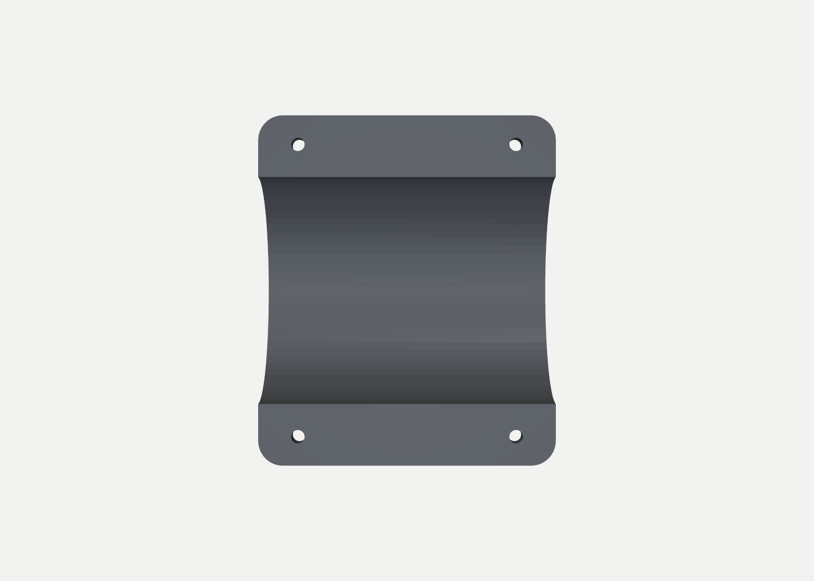
mechanical/output/renders/clamp_cap_top.png
