zredlined/esp32-race-logger-enclosure/mechanical/output/renders/saddle_bottom.png

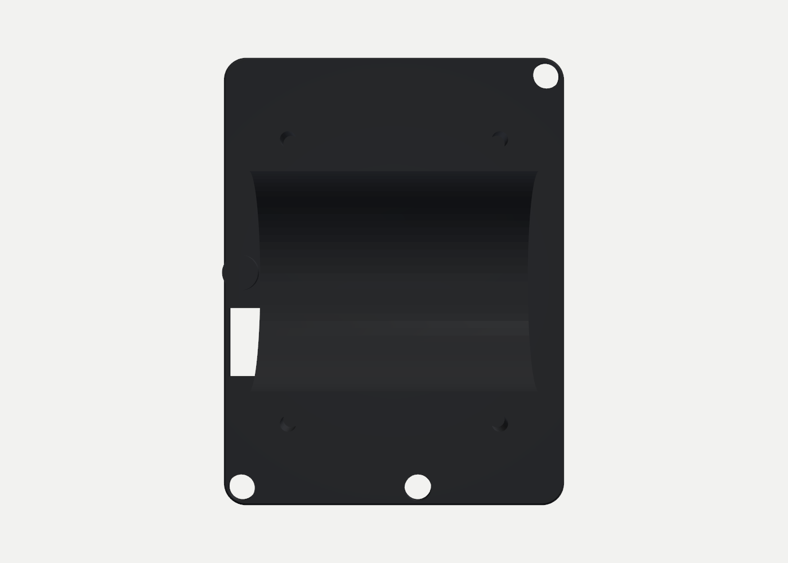
mechanical/output/renders/saddle_bottom.png
