zredlined/esp32-race-logger-enclosure/mechanical/output/renders/saddle_iso.png

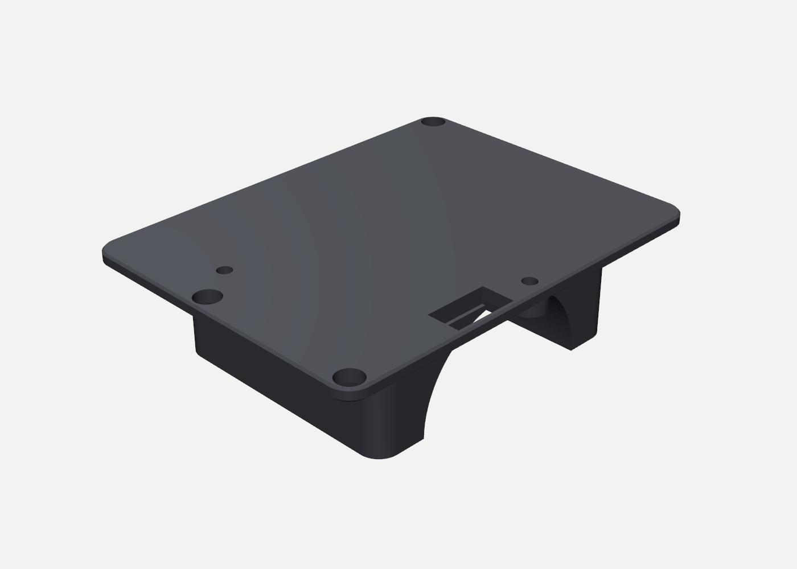
mechanical/output/renders/saddle_iso.png
