zredlined/esp32-race-logger-enclosure/mechanical/output/renders/saddle_right.png

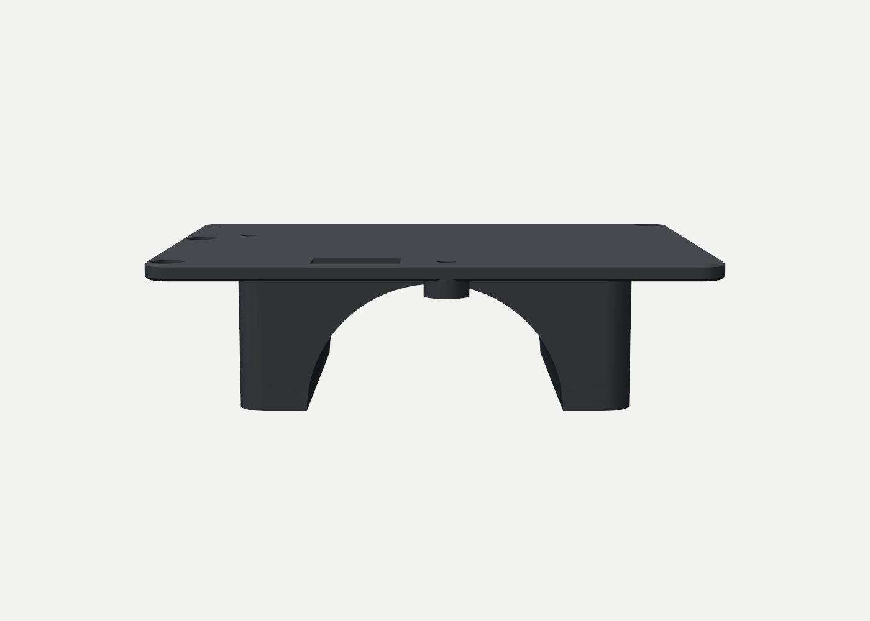
mechanical/output/renders/saddle_right.png
