zredlined/esp32-race-logger-enclosure/mechanical/output/renders/shell_bottom.png

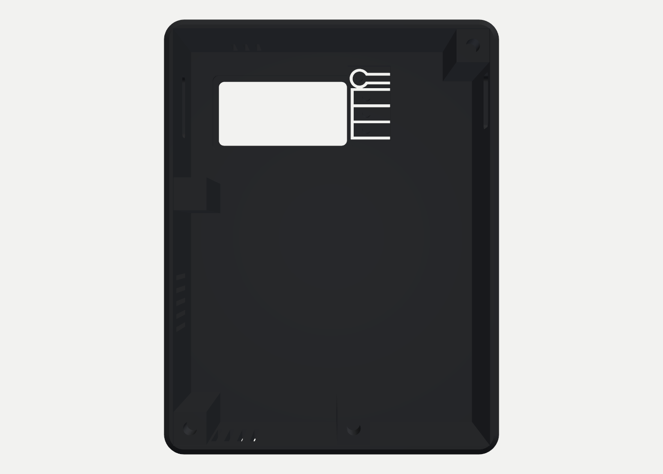
mechanical/output/renders/shell_bottom.png
