zredlined/esp32-race-logger-enclosure/mechanical/output/renders/shell_front.png

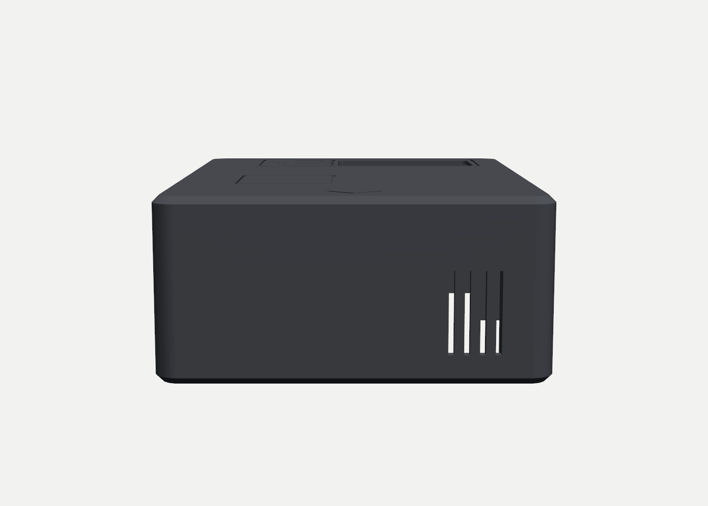
mechanical/output/renders/shell_front.png
