zredlined/esp32-race-logger-enclosure/mechanical/output/renders/shell_iso.png

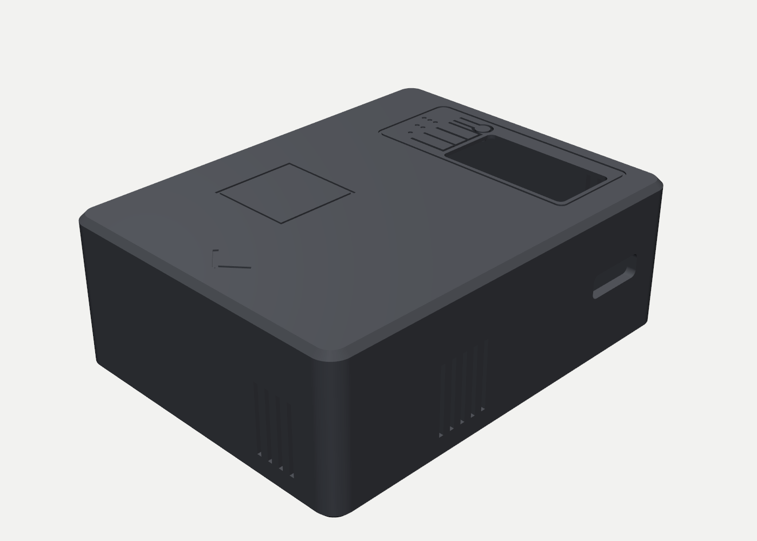
mechanical/output/renders/shell_iso.png
