zredlined/esp32-race-logger-enclosure/mechanical/output/renders/shell_iso_back.png

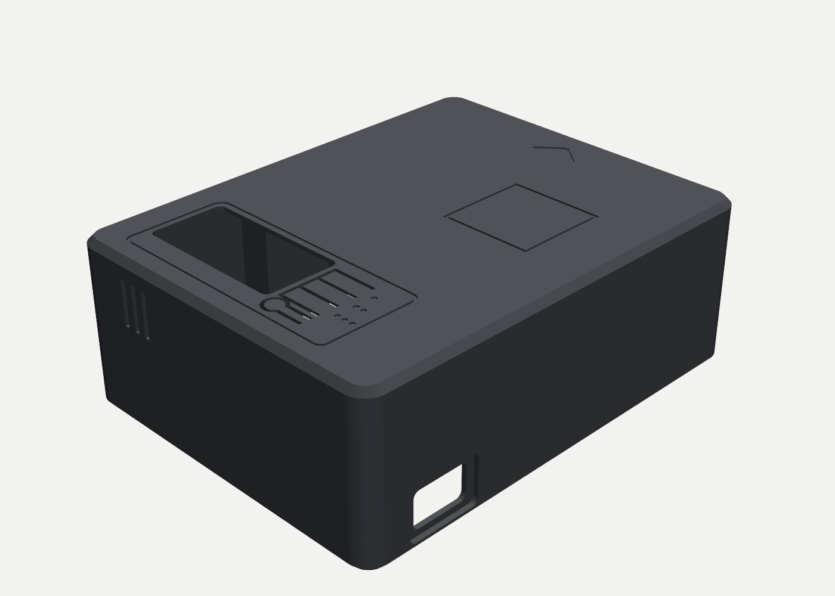
mechanical/output/renders/shell_iso_back.png
