zredlined/esp32-race-logger-enclosure/mechanical/output/renders/shell_keys_bottom_zoom.png

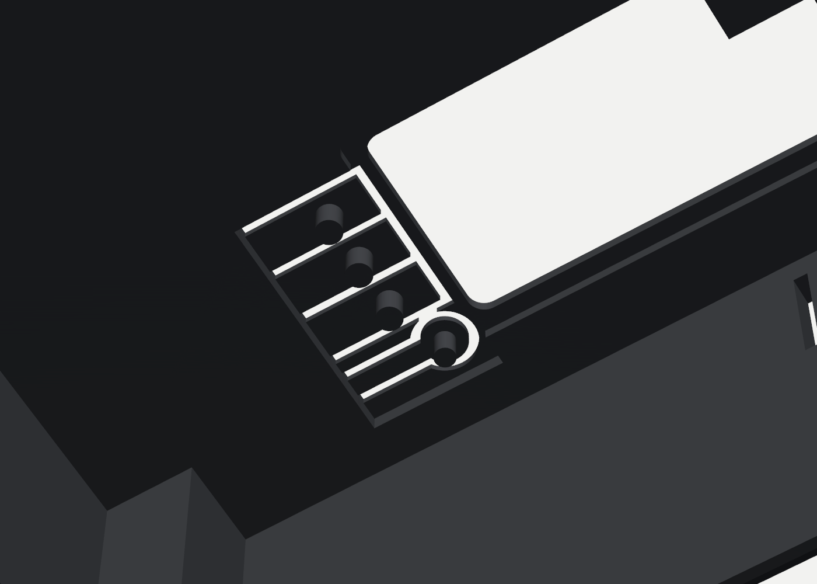
mechanical/output/renders/shell_keys_bottom_zoom.png
