zredlined/esp32-race-logger-enclosure/mechanical/output/renders/shell_keys_top_zoom.png

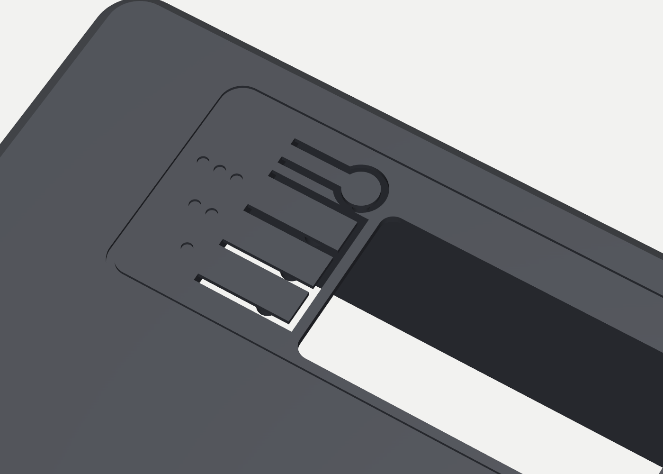
mechanical/output/renders/shell_keys_top_zoom.png
