zredlined/esp32-race-logger-enclosure/mechanical/output/renders/shell_top.png

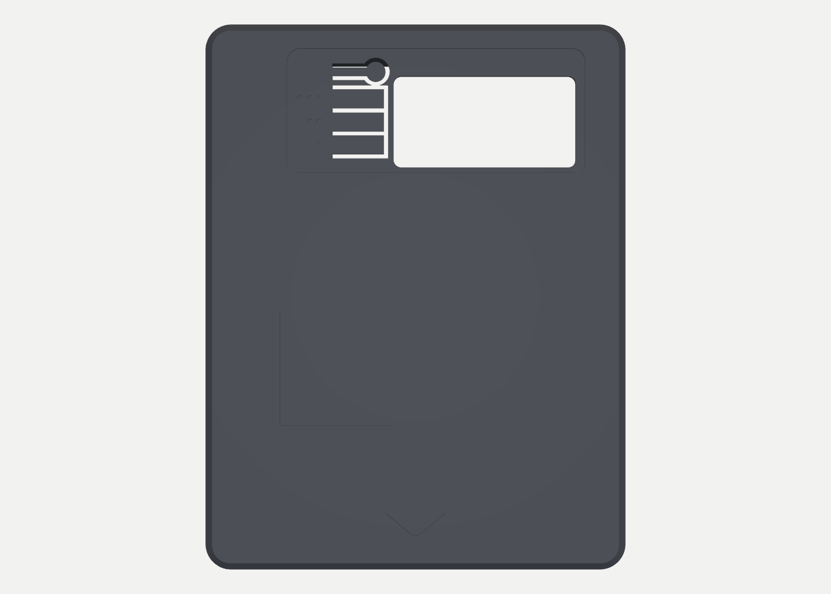
mechanical/output/renders/shell_top.png
