zredlined/esp32-race-logger-enclosure/mechanical/output/renders/shell_usb_zoom.png

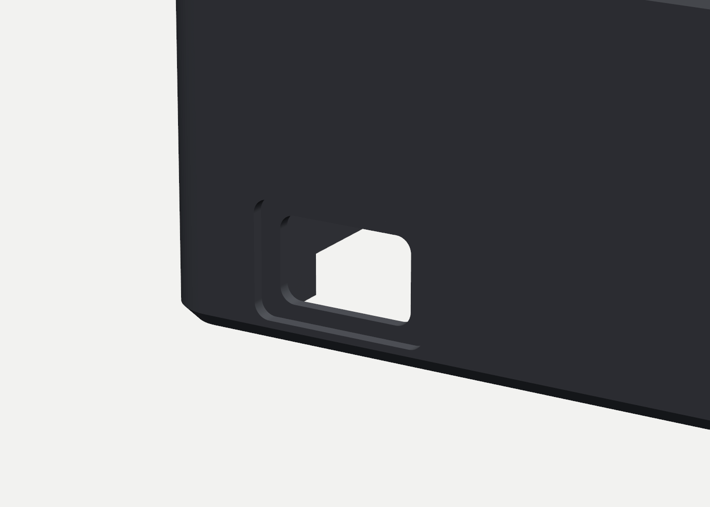
mechanical/output/renders/shell_usb_zoom.png
