zredlined/esp32-race-logger-enclosure/mechanical/output/renders/sled_in_shell_top.png

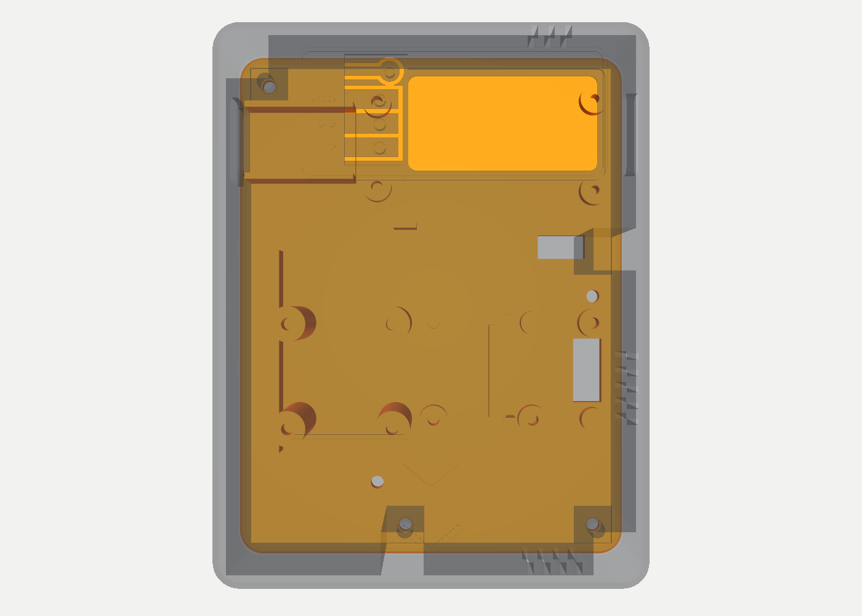
mechanical/output/renders/sled_in_shell_top.png
