zredlined/esp32-race-logger-enclosure/mechanical/output/renders/sled_iso.png

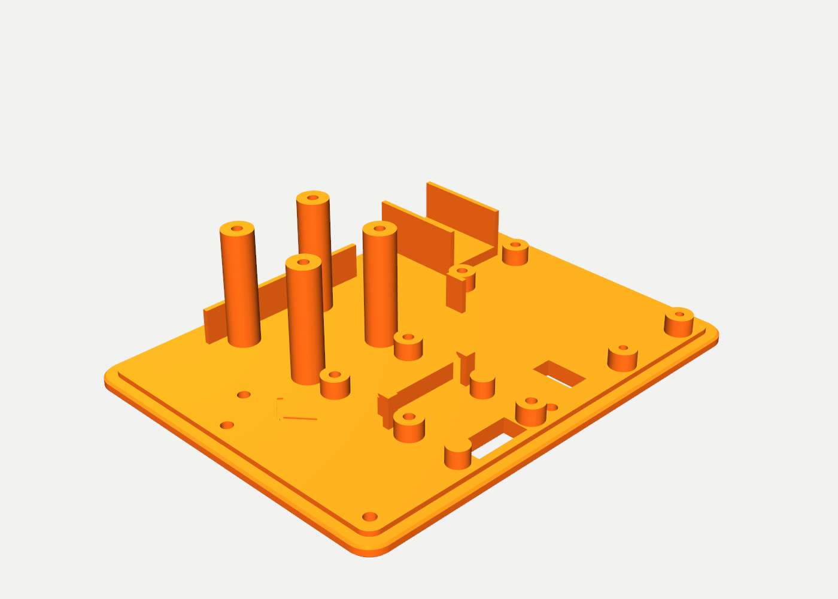
mechanical/output/renders/sled_iso.png
