zredlined/esp32-race-logger-enclosure/mechanical/output/renders/sled_iso_back.png

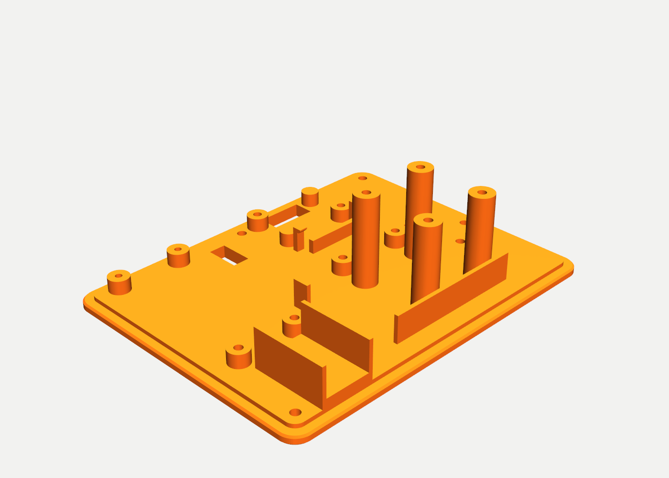
mechanical/output/renders/sled_iso_back.png
