zredlined/esp32-race-logger-enclosure/mechanical/output/renders/sled_right.png

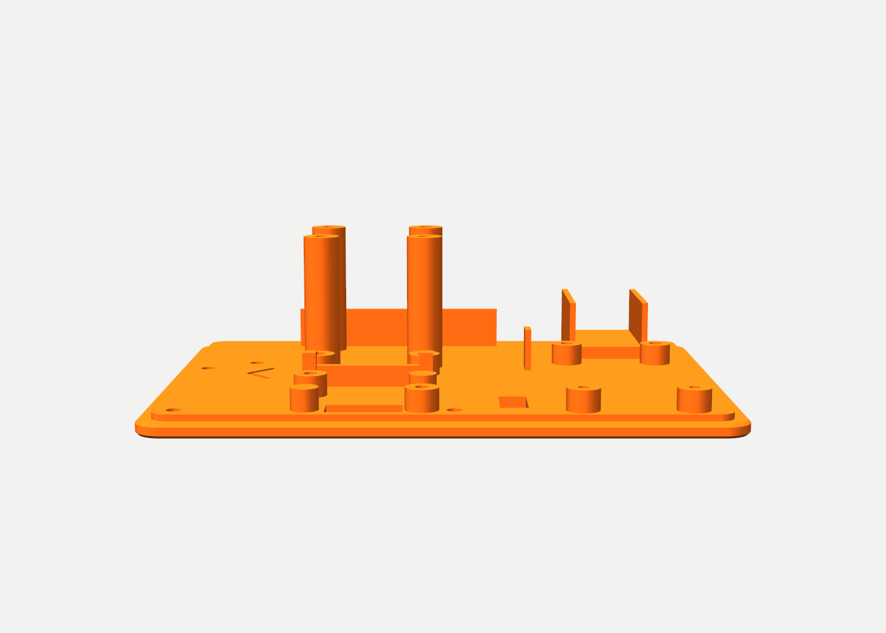
mechanical/output/renders/sled_right.png
