zredlined/esp32-race-logger-enclosure/mechanical/output/renders/sled_top.png

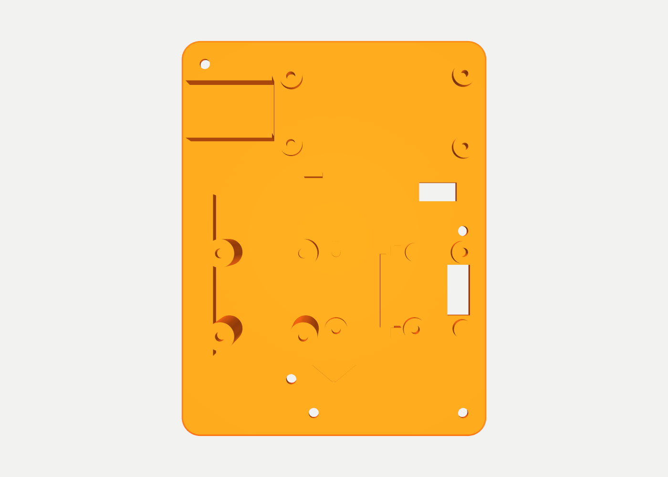
mechanical/output/renders/sled_top.png
