zredlined/esp32-race-logger-enclosure/mechanical/output/renders/sled_top_zoom_front.png

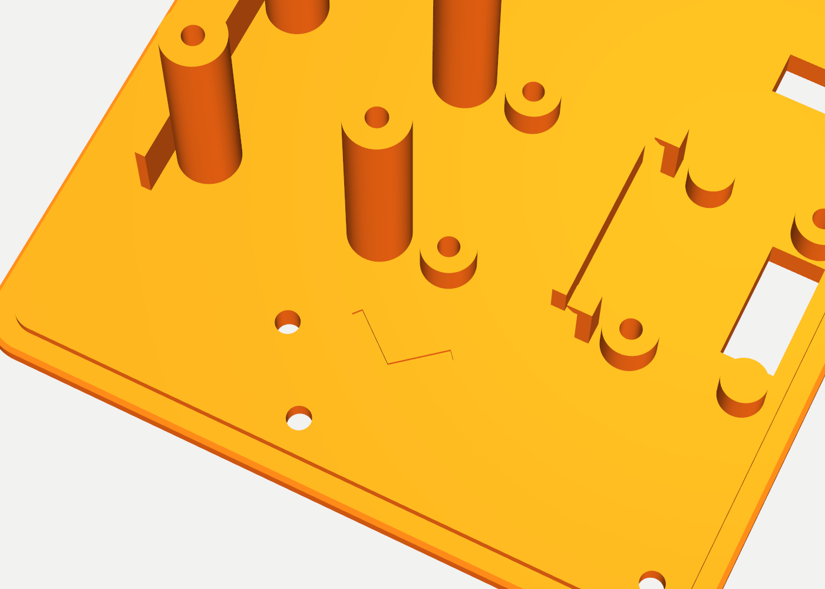
mechanical/output/renders/sled_top_zoom_front.png
