zredlined/esp32-race-logger-enclosure/mechanical/output/renders/tray_ads_zoom.png

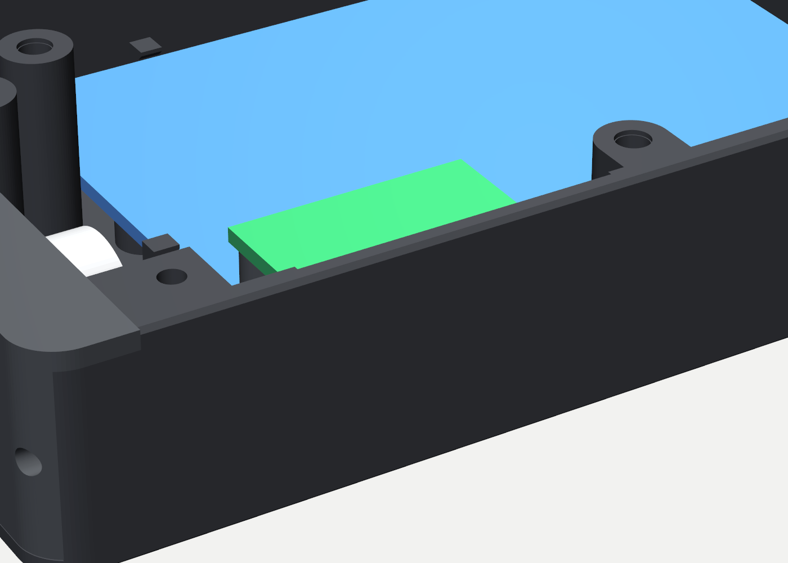
mechanical/output/renders/tray_ads_zoom.png
