zredlined/esp32-race-logger-enclosure/mechanical/output/renders/tray_bottom.png

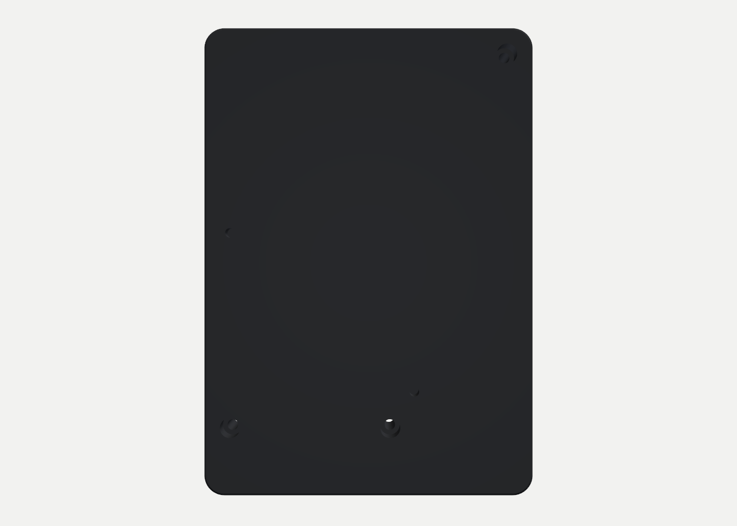
mechanical/output/renders/tray_bottom.png
