zredlined/esp32-race-logger-enclosure/mechanical/output/renders/tray_empty_iso.png

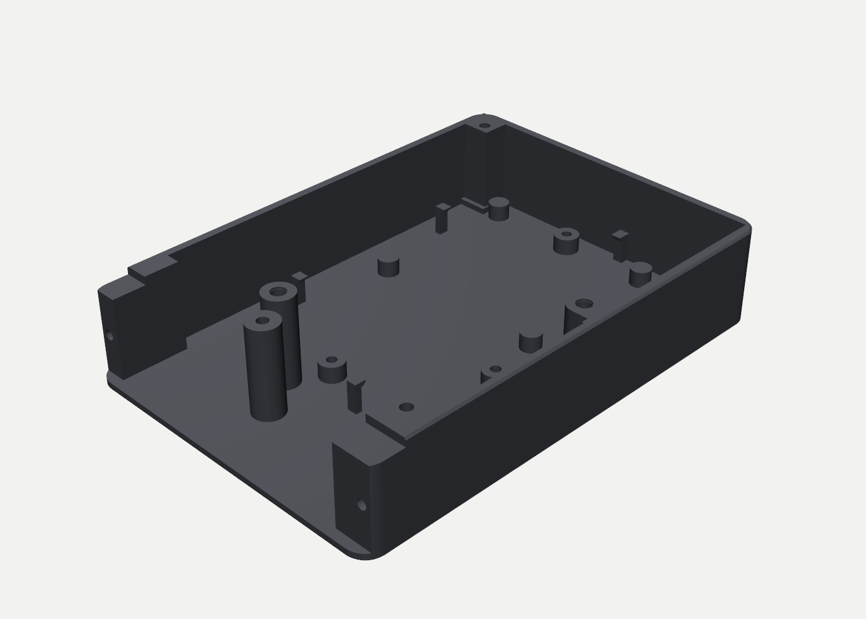
mechanical/output/renders/tray_empty_iso.png
