zredlined/esp32-race-logger-enclosure/mechanical/output/renders/tray_iso_back.png

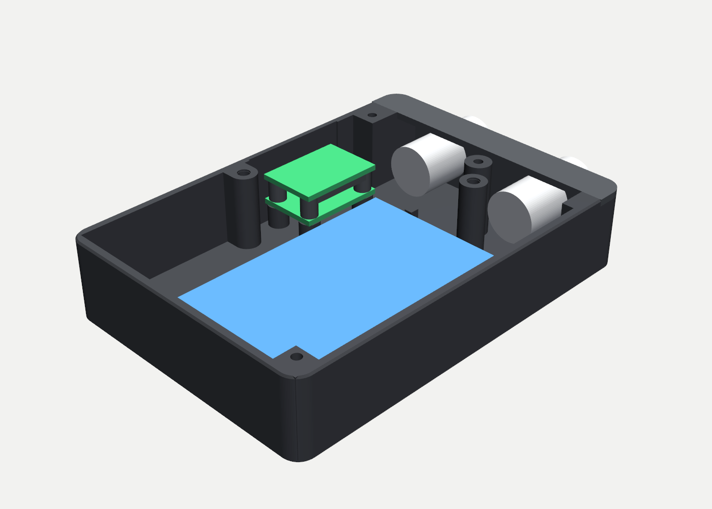
mechanical/output/renders/tray_iso_back.png
