zredlined/esp32-race-logger-enclosure/mechanical/output/renders/tray_top.png

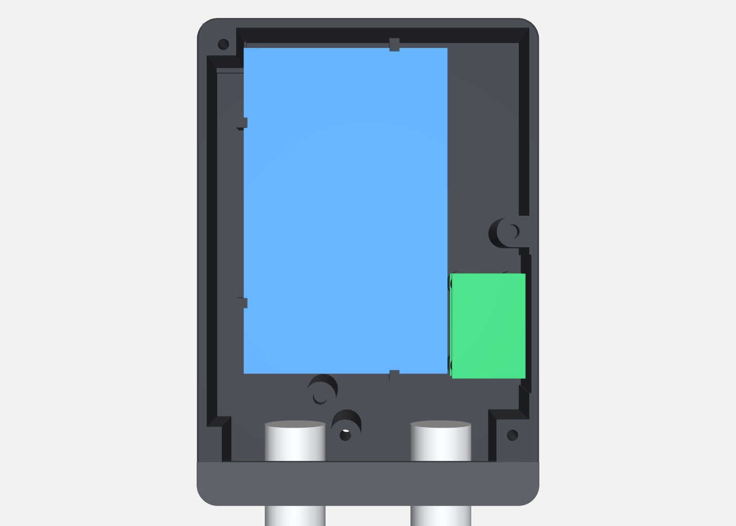
mechanical/output/renders/tray_top.png
