zredlined/esp32-race-logger-enclosure/mechanical/output/renders/universal_base_(gopro)_bottom.png

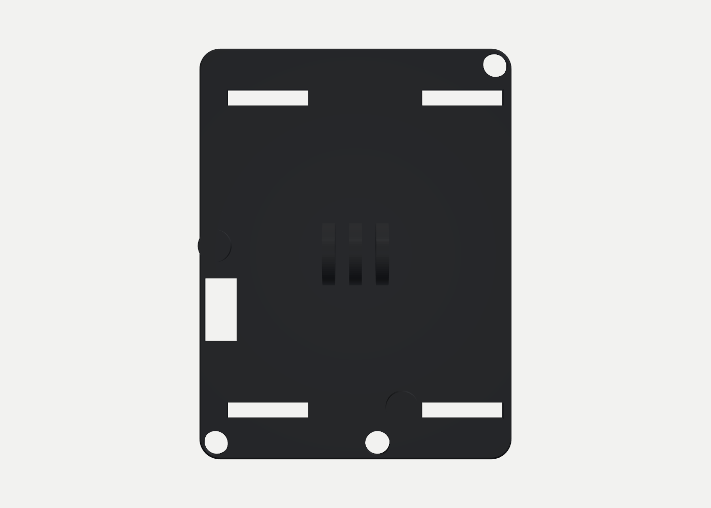
mechanical/output/renders/universal_base_(gopro)_bottom.png
