zredlined/esp32-race-logger-enclosure/mechanical/output/renders/universal_base_(gopro)_iso_back.png

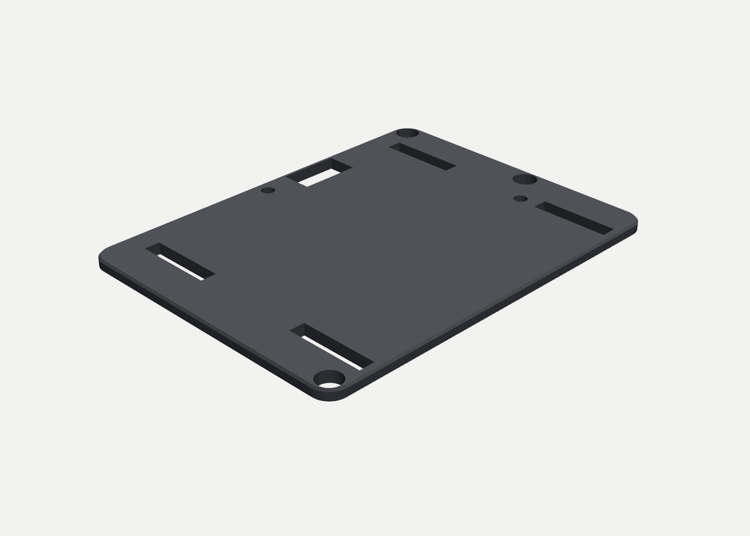
mechanical/output/renders/universal_base_(gopro)_iso_back.png
