zredlined/esp32-race-logger-enclosure/mechanical/output/renders/v1_exploded.png

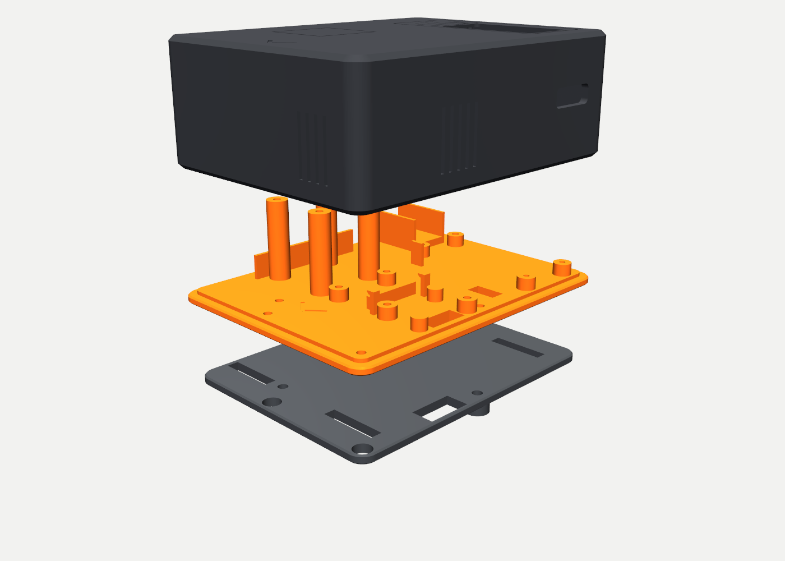
mechanical/output/renders/v1_exploded.png
