zredlined/esp32-race-logger-enclosure/mechanical/output/renders/v1_iso_back.png

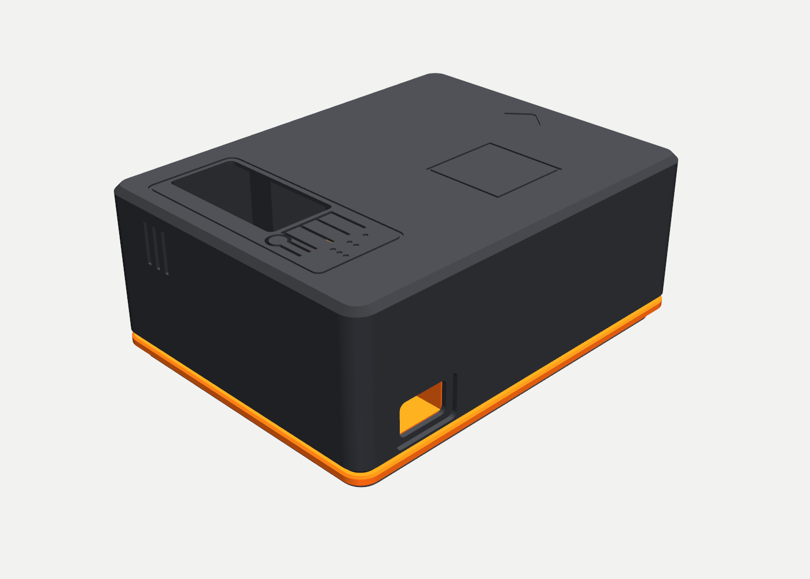
mechanical/output/renders/v1_iso_back.png
