zredlined/esp32-race-logger-enclosure/mechanical/output/renders/v1_right.png

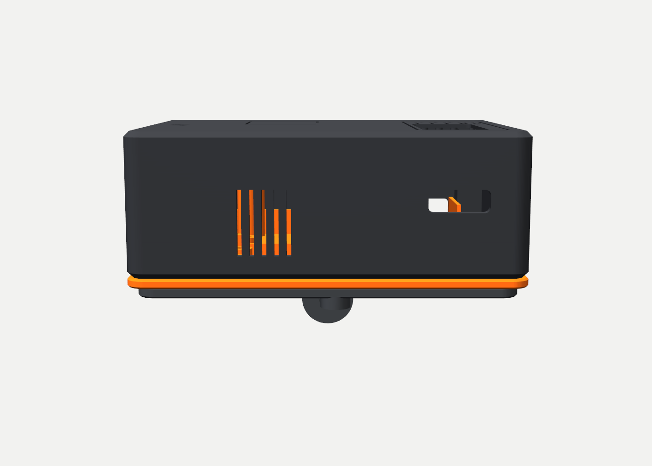
mechanical/output/renders/v1_right.png
