zredlined/esp32-race-logger-enclosure/mechanical/output/renders/v1_section_x.png

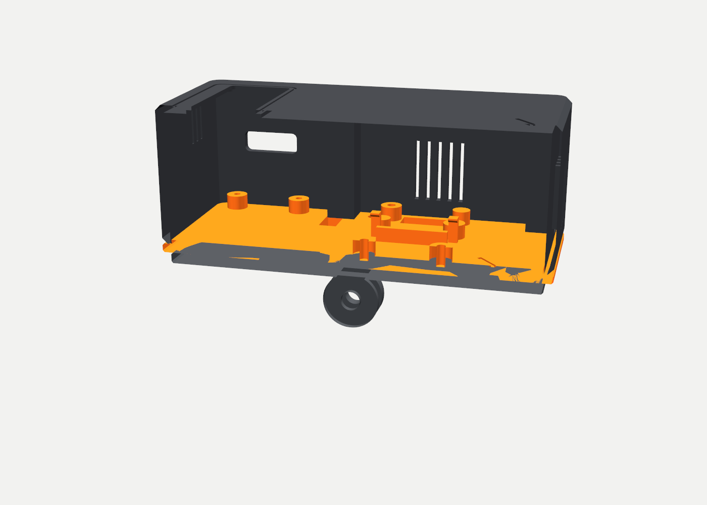
mechanical/output/renders/v1_section_x.png
