zredlined/esp32-race-logger-enclosure/mechanical/output/renders/v2_front_low.png

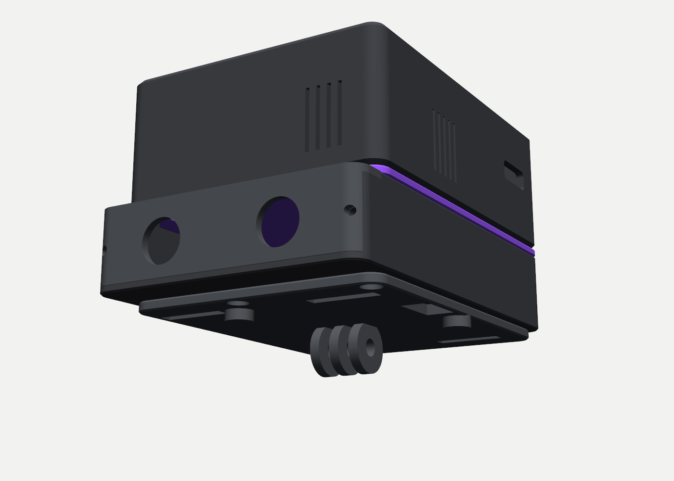
mechanical/output/renders/v2_front_low.png
