zredlined/esp32-race-logger-enclosure/mechanical/output/renders/v2_iso_back.png

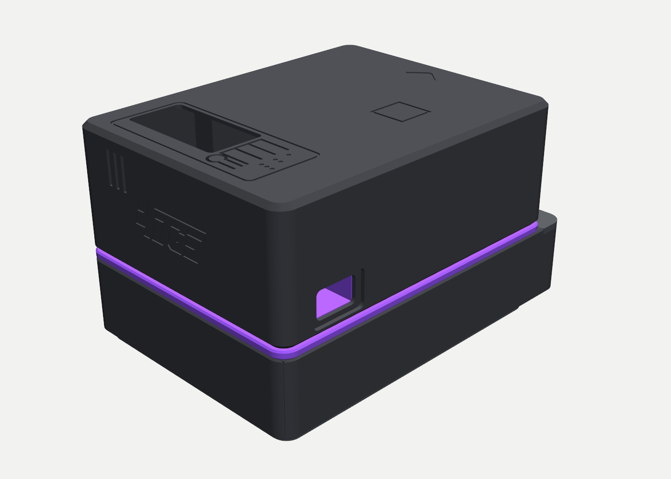
mechanical/output/renders/v2_iso_back.png
