zredlined/esp32-race-logger-enclosure/mechanical/output/renders/v2_right.png

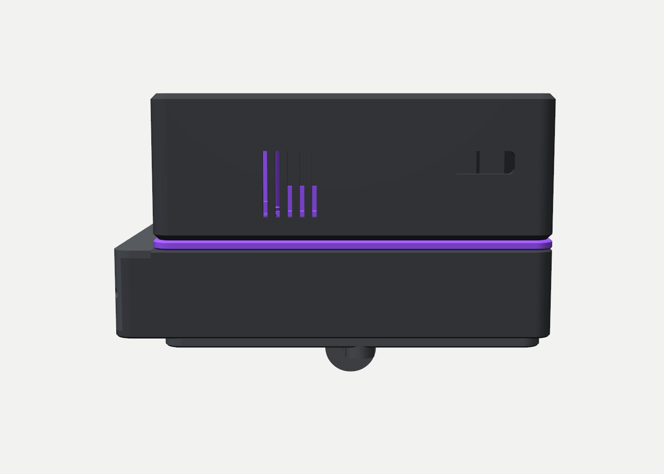
mechanical/output/renders/v2_right.png
