zredlined/esp32-race-logger-enclosure/mechanical/output/renders/v2_section_proto.png

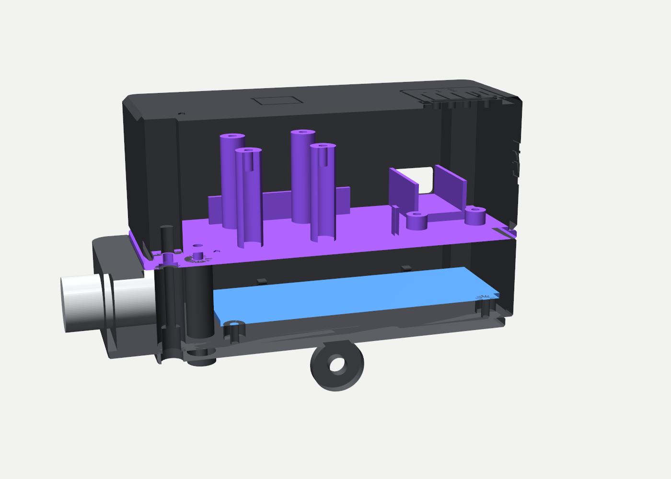
mechanical/output/renders/v2_section_proto.png
