zredlined/esp32-race-logger-enclosure/mechanical/output/renders/v2_section_y.png

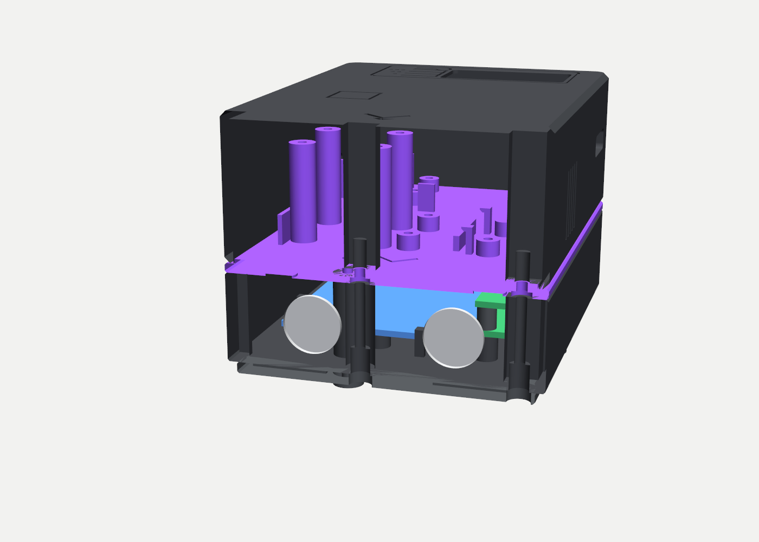
mechanical/output/renders/v2_section_y.png
