zredlined/esp32-race-logger-enclosure/mechanical/output/renders/variant_C2_back.png

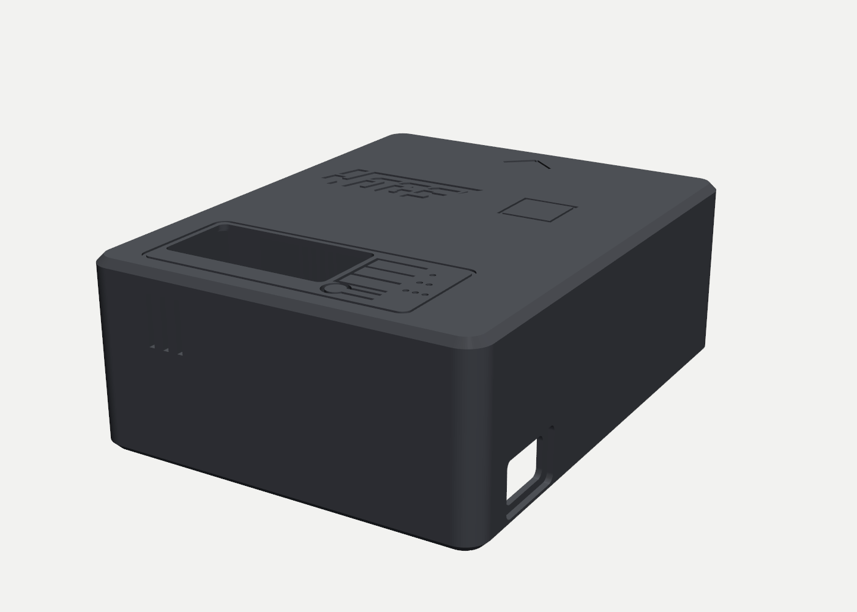
mechanical/output/renders/variant_C2_back.png
