zredlined/esp32-race-logger-enclosure/mechanical/reference/waveshare-7b/drawing_rot.png

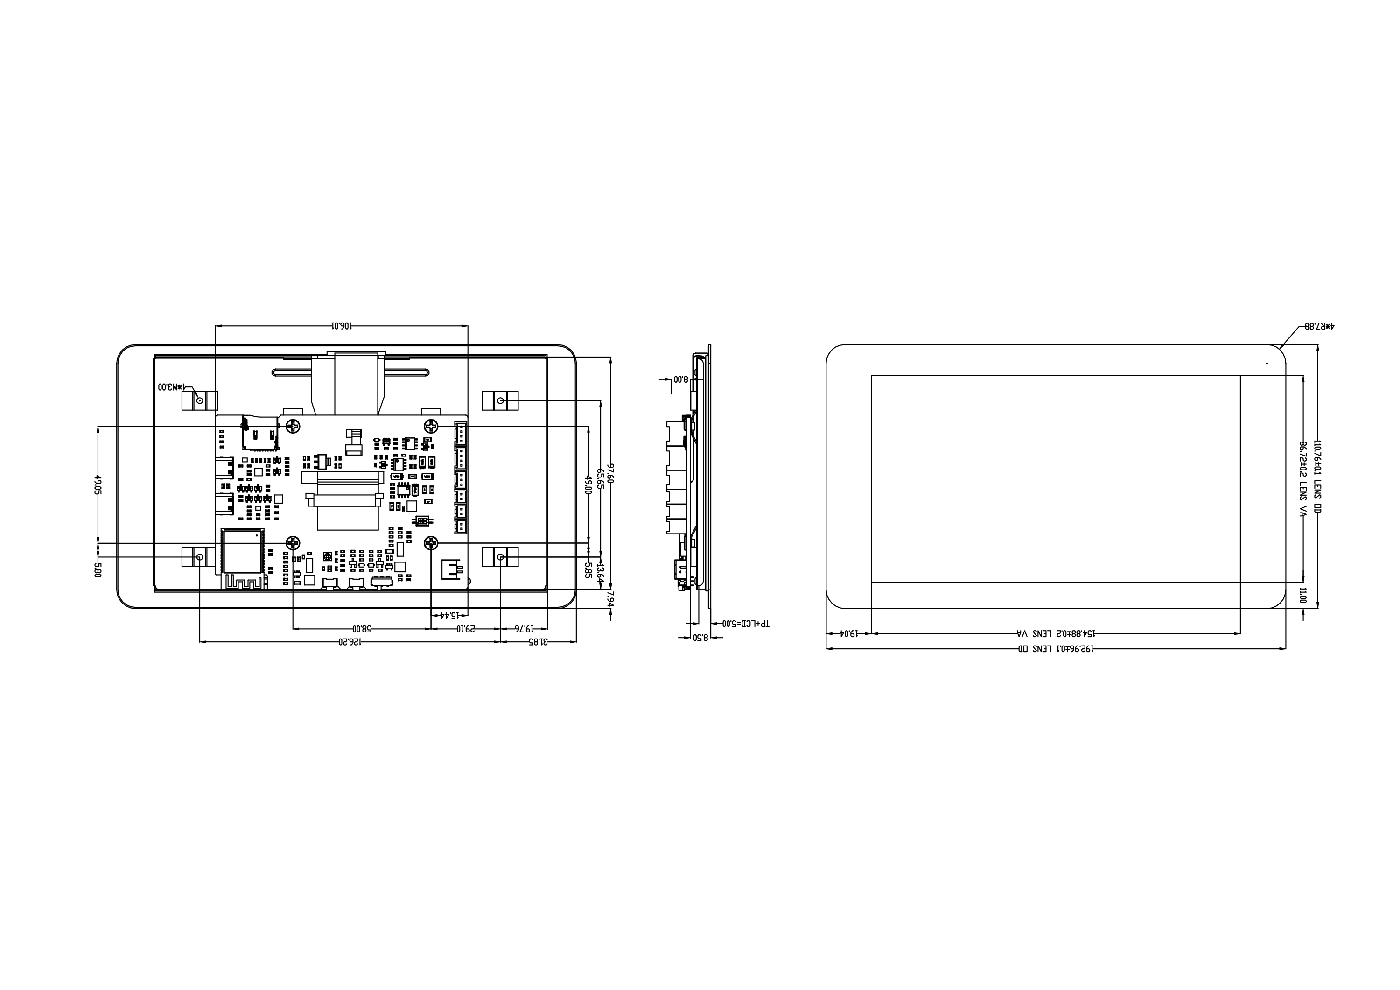
mechanical/reference/waveshare-7b/drawing_rot.png
