zredlined/esp32-race-logger-enclosure/docs/BOM.md

# BOM: ESP32 race logger enclosure

| Item | Vendor | Qty | Unit | Line | Stock | Note |
|---|---|---:|---:|---:|---|---|
| [ESP32-S3 Feather 4MB Flash 2MB PSRAM](https://www.adafruit.com/product/5477) | adafruit | 1 | $17.50 | $17.50 | owned (in stock) | controller |
| [Adalogger FeatherWing RTC + microSD](https://www.adafruit.com/product/2922) | adafruit | 1 | $8.95 | $8.95 | owned (in stock) | storage + RTC |
| [Feather stacking headers](https://www.adafruit.com/product/2830) | adafruit | 1 | $1.25 | $1.25 | owned (in stock) | on the Feather (bottom of stack) |
| [Feather stacking headers (2nd set)](https://www.adafruit.com/product/2830) | adafruit | 1 | $1.25 | $1.25 | in stock | needed on the Adalogger so the OLED Wing can sit on top; a 3-board stack needs sockets on two boards |
| [Mini GPS PA1010D STEMMA QT](https://www.adafruit.com/product/4415) | adafruit | 1 | $29.95 | $29.95 | owned (in stock) | GPS |
| [LSM6DSOX 6-DoF IMU](https://www.adafruit.com/product/4438) | adafruit | 1 | $11.95 | $11.95 | owned (out of stock) | IMU |
| [SHT41 temp/humidity STEMMA QT](https://www.adafruit.com/product/5776) | adafruit | 1 | $5.95 | $5.95 | owned (in stock) | ambient sensor per recent order (firmware says HDC3022 5989 |
| [Assembled FeatherWing OLED 128x64 STEMMA QT (SH1107](https://www.adafruit.com/product/6313) | adafruit | 1 | $15.95 | $15.95 | owned (in stock) | display + buttons |
| [STEMMA QT cable 100 mm](https://www.adafruit.com/product/4210) | adafruit | 3 | $0.95 | $2.85 | owned (in stock) | OLED->GPS |
| [STEMMA QT cable 200 mm](https://www.adafruit.com/product/4401) | adafruit | 1 | $1.25 | $1.25 | in stock | OLED Wing -> GPS hop runs down the left wall (~130 mm route) |
| [CR1220 coin cell for RTC](https://www.adafruit.com/product/380) | adafruit | 1 | $0.95 | $0.95 | out of stock | Adalogger RTC backup |
| [M2.5 heat-set inserts](https://www.mcmaster.com/94180A321/) | other | 12 | $0.30 | $3.60 | owned (unknown) (unverified) | owned |
| [M2.5 screws assorted](https://www.mcmaster.com/) | other | 12 | $0.10 | $1.20 | owned (unknown) (unverified) | owned |
| [M2 x 6 screws (Feather far-end holes)](https://www.mcmaster.com/) | other | 2 | $0.10 | $0.20 | owned (unknown) (unverified) | user has M2 |
| [ADS1115 16-bit ADC STEMMA QT (x2](https://www.adafruit.com/product/1085) | adafruit | 2 | $14.95 | $29.90 | in stock | addresses 0x48 and 0x49 |
| [ALTERNATIVE: Weewooday ADS1115 header modules, 6-pack (use 2 on the proto board instead of the Adafruit pair)](https://www.amazon.com/dp/B0DP43DDZG) | other | 0 | $19.99 | $0.00 | unknown (unverified) | no STEMMA QT; mount on the perma-proto |
| [DIKAVS Perma-Proto half-size solderable breadboard (5-pack)](https://www.amazon.com/DIKAVS-Full-Sized-Perma-Proto-Breadboard-Solder-able/dp/B09ZPGGVSR) | other | 1 | $12.00 | $12.00 | owned (unknown) (unverified) | ordered 2026-10-02; 51 x 81.5 mm |
| [M12 8-pin A-coded panel receptacle](https://www.amazon.com/Bulkhead-Connector-Receptacles-Straight-Waterproof/dp/B09LD3F1S5) | other | 2 | $9.00 | $18.00 | unknown (unverified) | connector card; nut/flange <= 17 mm |
| [M2.5 x 25 (x3 shell)](https://www.mcmaster.com/) | other | 11 | $0.10 | $1.10 | owned (unknown) (unverified) | all from the owned kit; plus 2 owned inserts for the tray column tops |
| [M2.5 x 8 self-tap (x2 card) and M2.5 x 6 (x2 proto)](https://www.mcmaster.com/) | other | 4 | $0.10 | $0.40 | owned (unknown) (unverified) | from the owned assortment |
| [STEMMA QT cable 50 mm (ADS hairpin)](https://www.adafruit.com/product/4399) | adafruit | 1 | $0.95 | $0.95 | owned (in stock) | lower ADS front -> upper ADS front |
| [STEMMA QT cable 100 mm (drop slot)](https://www.adafruit.com/product/4210) | adafruit | 1 | $0.95 | $0.95 | owned (in stock) | SHT41 rear -> upper ADS rear |

**To buy: $51.35**  +  shipping estimate $0.00  =  **$51.35**
Already owned (not in total): $114.75

## Needs attention

- CR1220 coin cell for RTC: out of stock
- ALTERNATIVE: Weewooday ADS1115 header modules, 6-pack (use 2 on the proto board instead of the Adafruit pair): unknown
- M12 8-pin A-coded panel receptacle: unknown
