zredlined/esp32-race-logger-enclosure/mechanical/display/output/bench_stand.stl

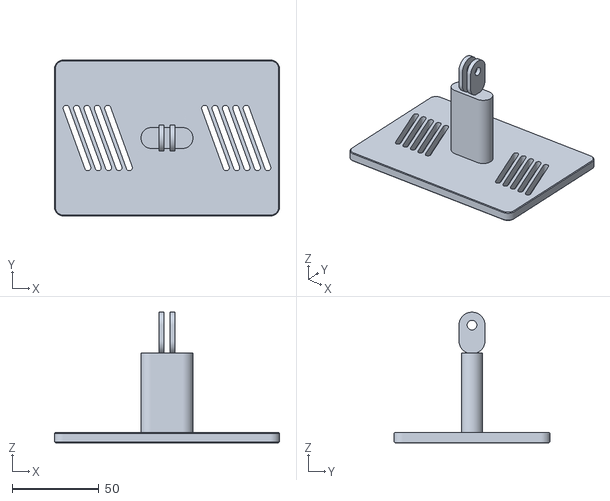
[picture p84: CAD file, 2026-10-18]
mechanical/display/output/bench_stand.stl
130.0 x 90.0 x 75.5
