zredlined/esp32-race-logger-enclosure/mechanical/display/stand-and-gopro-puck.3mf

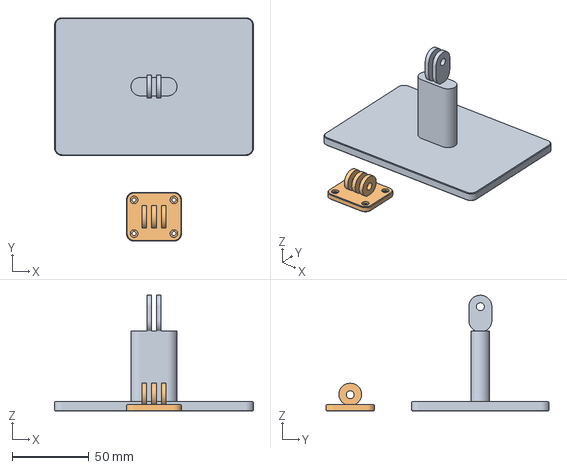
[picture p85: CAD file, 2026-10-18]
mechanical/display/stand-and-gopro-puck.3mf
130.0 x 146.0 x 75.5 mm
bench_stand.stl
print_gopro_puck.stl
