zredlined/esp32-race-logger-enclosure/mechanical/output/bambu-labs/esp32-race-logger-shell-with-supports.3mf

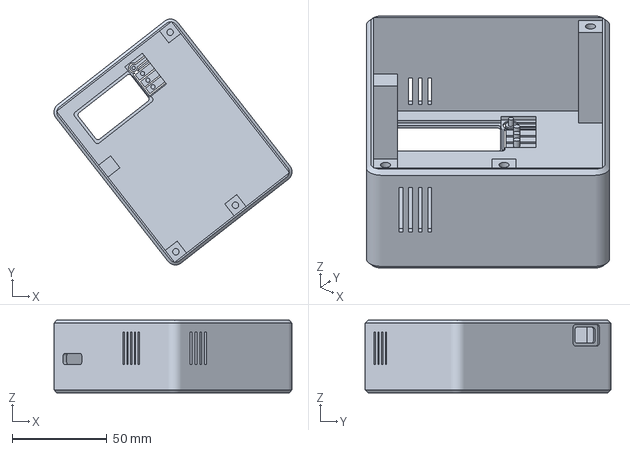
[picture p86: CAD file, 2026-10-18]
mechanical/output/bambu-labs/esp32-race-logger-shell-with-supports.3mf
125.4 x 129.6 x 38.3 mm
