zredlined/esp32-race-logger-enclosure/mechanical/output/saddle.stl

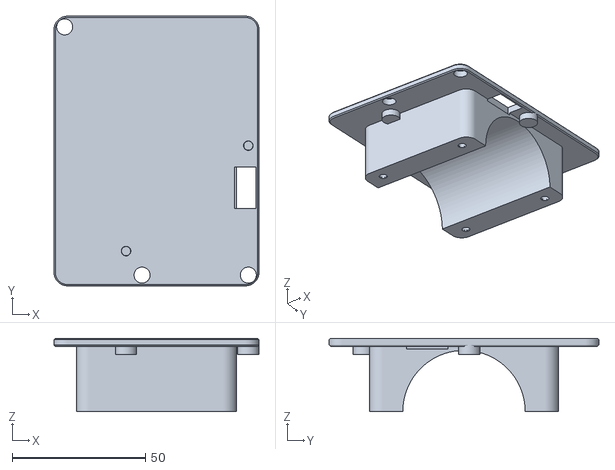
[picture p87: CAD file, 2026-10-18]
mechanical/output/saddle.stl
76.8 x 101.0 x 27.4
