zredlined/esp32-race-logger-enclosure/mechanical/reference/waveshare-7b/ESP32-S3-Touch-LCD-7B.stp

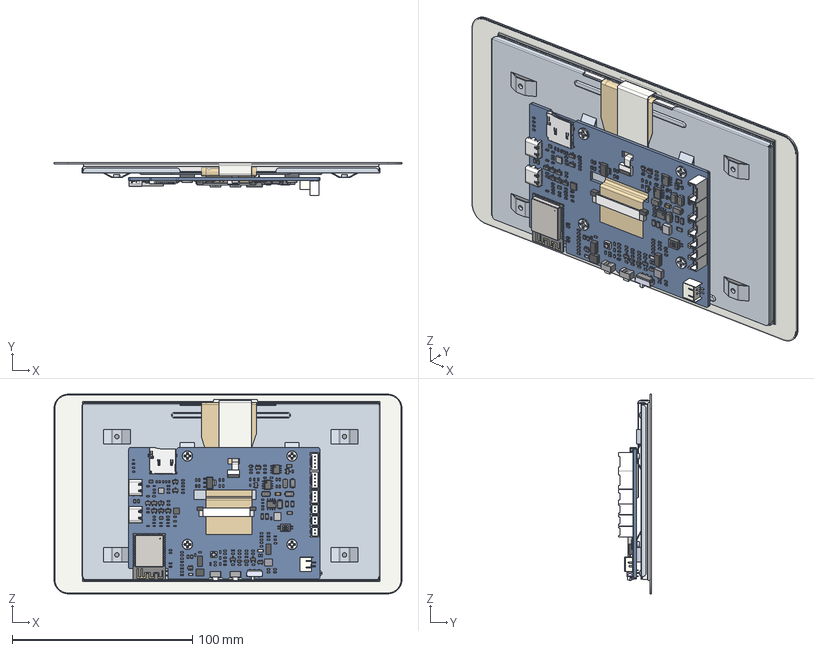
[picture p88: CAD file, 2026-10-18]
mechanical/reference/waveshare-7b/ESP32-S3-Touch-LCD-7B.stp
193.0 x 18.4 x 110.8 mm
7INCH-800X480-TP
7INCH-800X480-LCD
7INCH-DSI-TOUCHSCREEN-BRACKET
EVA
BOARD
SOT23-5AND6_00 x 5
SOT23-5-14065_AF0
_2_1_2_3_4_AF0 x 51
_7_1_2_AF0 x 51
SOT-23 x 10
SOD323
3_1_2_A x 20
CSW1_27-SMD-2P-913
C0201_20210301_STEP_C0201_20210 x 14
L0201_20210301_STEP_L0201_20210 x 3
C0402_20210301_STEP_C0402_20210
R0201_20210301_STEP_R0201_202_1 x 8
R0201_20210301_STEP_R0201_202_2 x 8
R0201_20210301_STEP_R0201_202_3 x 8
TRACE_1_SUBMODEL-MINI-ANT-TYPEB
DFN1006_STEP_DFN1006_STEP_SUBMO
SOP8_REV1_20210308_STEP_SOP8_RE
XTAL3225_20210301_STEP_XTAL32_1
XTAL3225_20210301_STEP_XTAL32_2
XTAL3225_20210301_STEP_XTAL32_3
XTAL3225_20210301_STEP_XTAL32_4
XTAL3225_20210301_STEP_XTAL32_5
ESP32-S3_20210301_STEP_ESP32-_1
ESP32-S3_20210301_STEP_ESP32-_2
UID__4-128_DESIGNROOTMODEL_PCB_
UID__4-129_DESIGNROOTMODEL_PCB_
UID__4-130_DESIGNROOTMODEL_PCB_
UID__4-149_DESIGNROOTMODEL_PCB_
UID__4-150_DESIGNROOTMODEL_PCB_
UID__4-151_DESIGNROOTMODEL_PCB_
UID__4-167_DESIGNROOTMODEL_PCB_
UID__4-168_DESIGNROOTMODEL_PCB_
UID__4-169_DESIGNROOTMODEL_PCB_
UID__1-279_DESIGNROOTMODEL_PCB_
UID__1-280_DESIGNROOTMODEL_PCB_
UID__1-292_DESIGNROOTMODEL_PCB_
UID__1-298_DESIGNROOTMODEL_PCB_
UID__1-299_DESIGNROOTMODEL_PCB_
UID__1-300_DESIGNROOTMODEL_PCB_
UID__1-301_DESIGNROOTMODEL_PCB_
UID__1-304_DESIGNROOTMODEL_PCB_
UID__1-305_DESIGNROOTMODEL_PCB_
UID__1-308_DESIGNROOTMODEL_PCB_
UID__1-310_DESIGNROOTMODEL_PCB_
UID__1-311_DESIGNROOTMODEL_PCB_
UID__1-325_DESIGNROOTMODEL_PCB_
UID__1-334_DESIGNROOTMODEL_PCB_
UID__1-338_DESIGNROOTMODEL_PCB_
UID__1-339_DESIGNROOTMODEL_PCB_
UID__1-340_DESIGNROOTMODEL_PCB_
UID__1-343_DESIGNROOTMODEL_PCB_
UID__1-344_DESIGNROOTMODEL_PCB_
UID__1-345_DESIGNROOTMODEL_PCB_
UID__1-352_DESIGNROOTMODEL_PCB_
UID__1-354_DESIGNROOTMODEL_PCB_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
