zredlined/esp32-race-logger-enclosure/mechanical/display/output/backpack.3mf

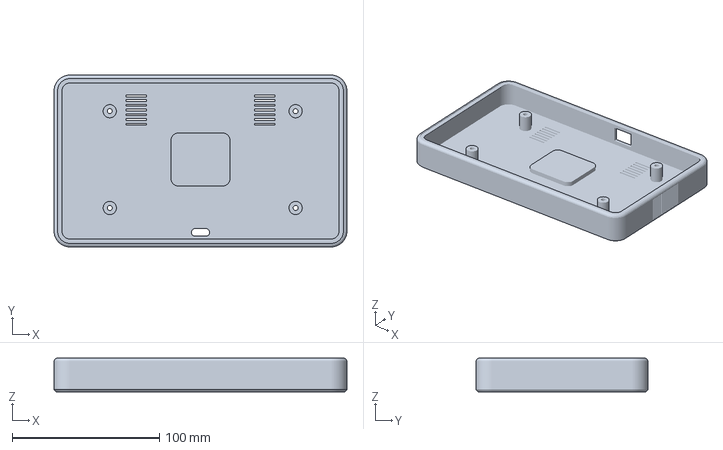
[picture p89: CAD file, 2026-10-18]
mechanical/display/output/backpack.3mf
199.0 x 116.8 x 23.0 mm
