zredlined/esp32-race-logger-enclosure/mechanical/output/bambu-labs/esp32-sled.3mf

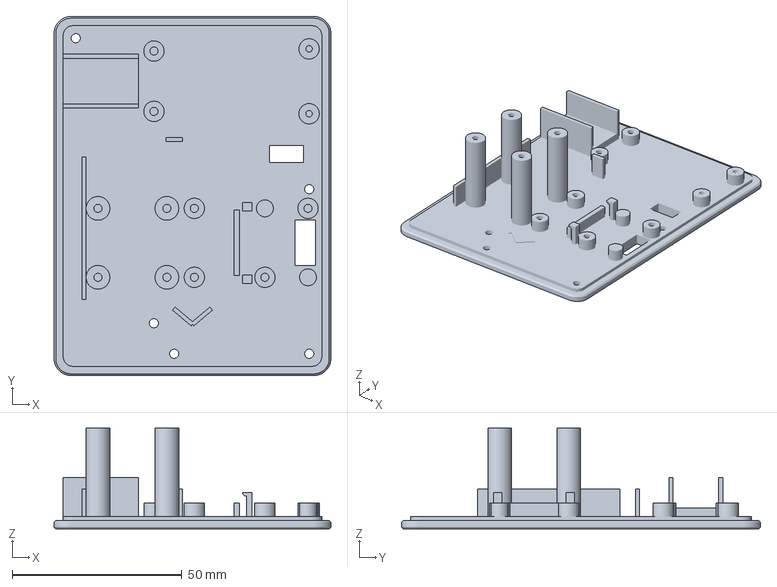
[picture p90: CAD file, 2026-10-18]
mechanical/output/bambu-labs/esp32-sled.3mf
81.6 x 105.8 x 29.7 mm
