zredlined/esp32-race-logger-enclosure/mechanical/output/clamp_cap.stl

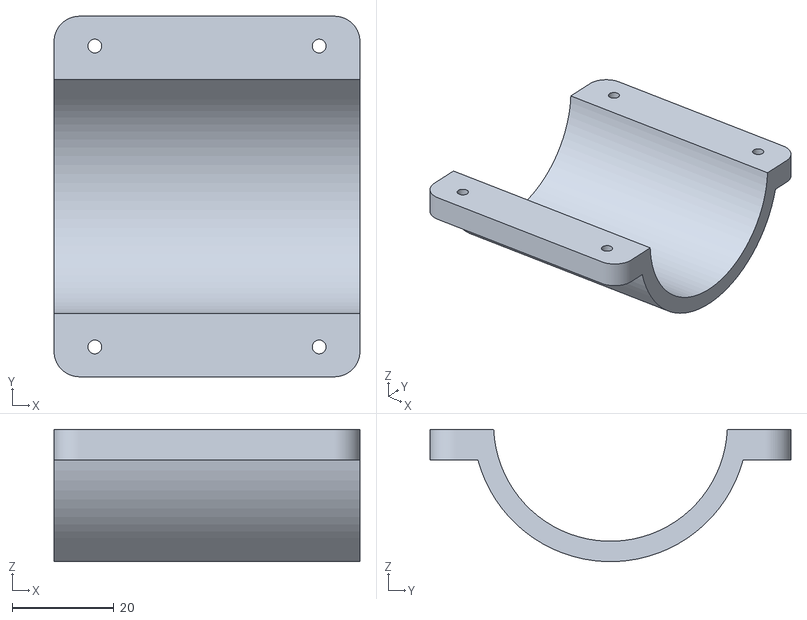
[picture p91: CAD file, 2026-10-18]
mechanical/output/clamp_cap.stl
60.0 x 70.7 x 25.9
