zredlined/esp32-race-logger-enclosure/mechanical/display/output/print_depth_coupon.stl

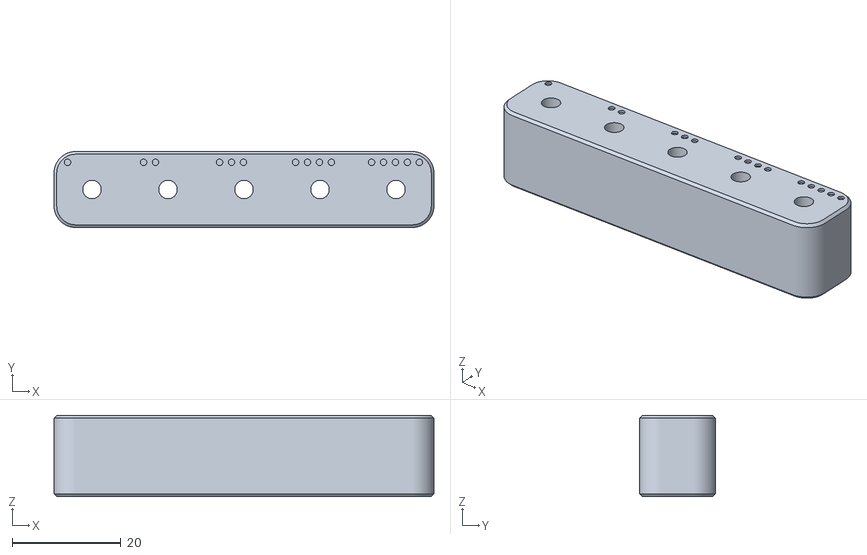
[picture p92: CAD file, 2026-10-18]
mechanical/display/output/print_depth_coupon.stl
70.0 x 14.0 x 15.0
