zredlined/esp32-race-logger-enclosure/mechanical/output/universal_base_(gopro).stl

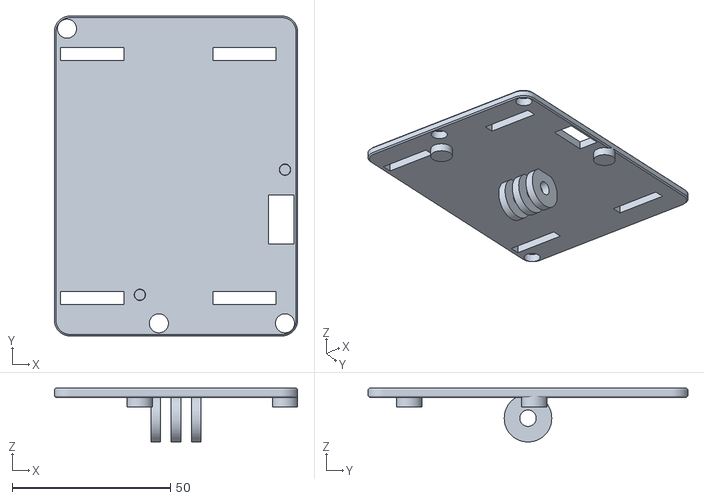
[picture p93: CAD file, 2026-10-18]
mechanical/output/universal_base_(gopro).stl
76.8 x 101.0 x 17.0
