zredlined/esp32-race-logger-enclosure/mechanical/output/test_coupon.stl

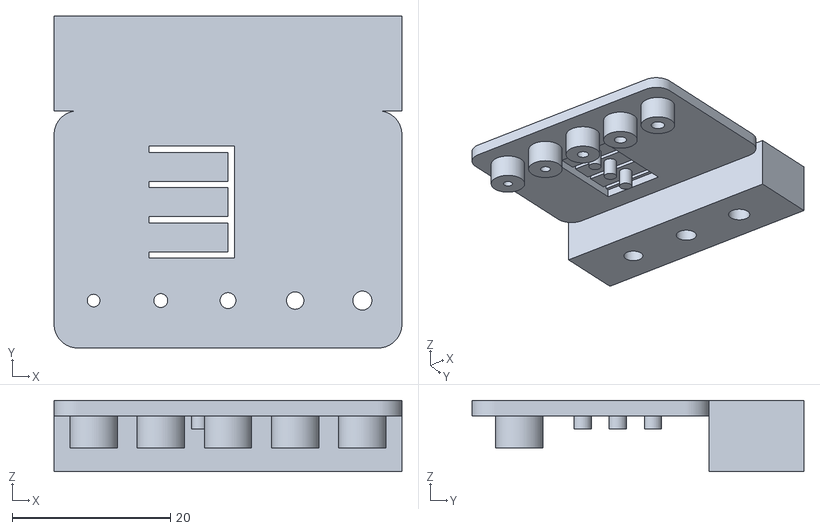
[picture p94: CAD file, 2026-10-18]
mechanical/output/test_coupon.stl
44.0 x 42.0 x 9.00
