zredlined/esp32-race-logger-enclosure/mechanical/display/output/gopro_puck.stl

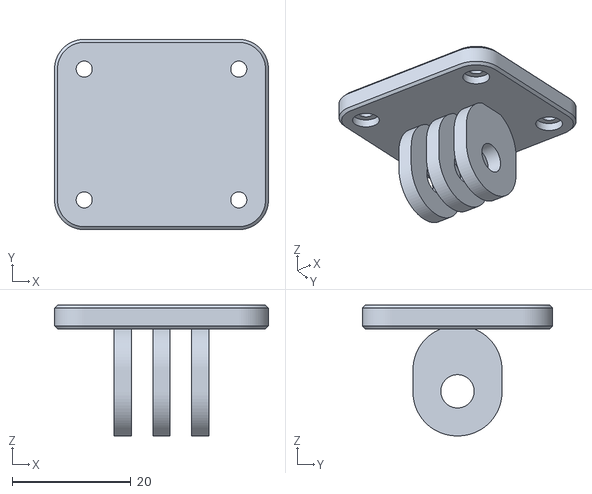
[picture p96: CAD file, 2026-10-18]
mechanical/display/output/gopro_puck.stl
36.0 x 32.0 x 22.0
