zredlined/esp32-race-logger-enclosure/mechanical/output/analog_tray.stl

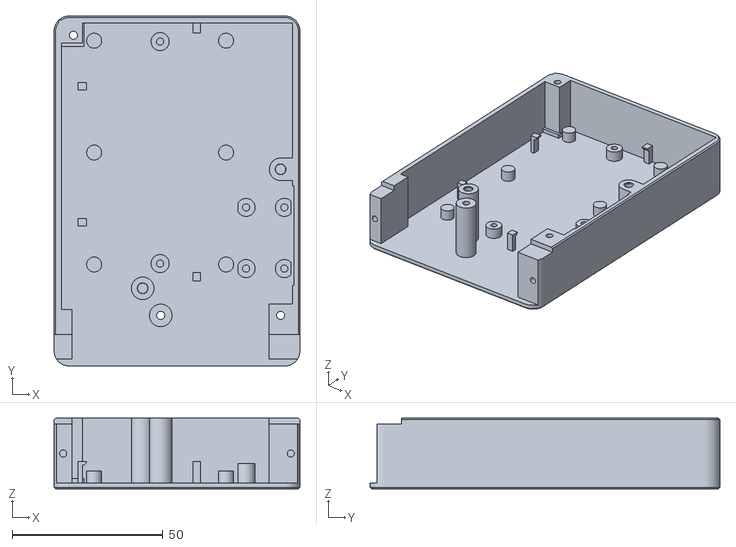
[picture p97: CAD file, 2026-10-18]
mechanical/output/analog_tray.stl
81.6 x 116.2 x 23.5
