zredlined/esp32-race-logger-enclosure/mechanical/output/ads_riser_frame.stl

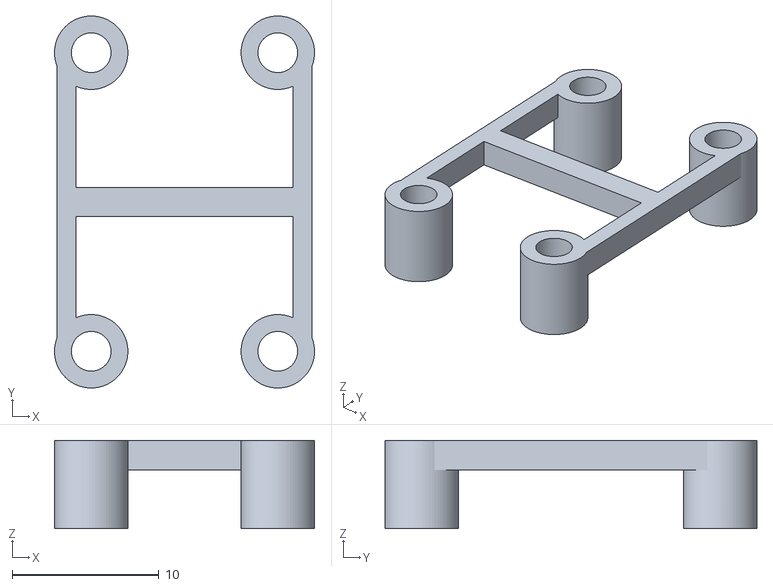
[picture p98: CAD file, 2026-10-18]
mechanical/output/ads_riser_frame.stl
17.7 x 25.3 x 6.00
