zredlined/esp32-race-logger-enclosure/mechanical/output/connector_card_(blank).stl

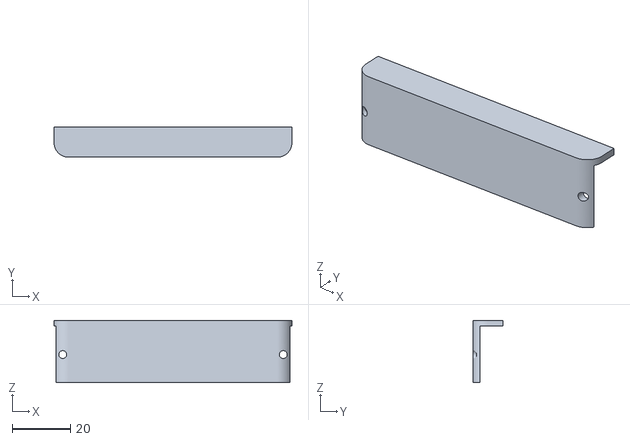
[picture p99: CAD file, 2026-10-18]
mechanical/output/connector_card_(blank).stl
81.6 x 10.4 x 21.4
