zredlined/esp32-race-logger-enclosure/mechanical/output/shell.stl

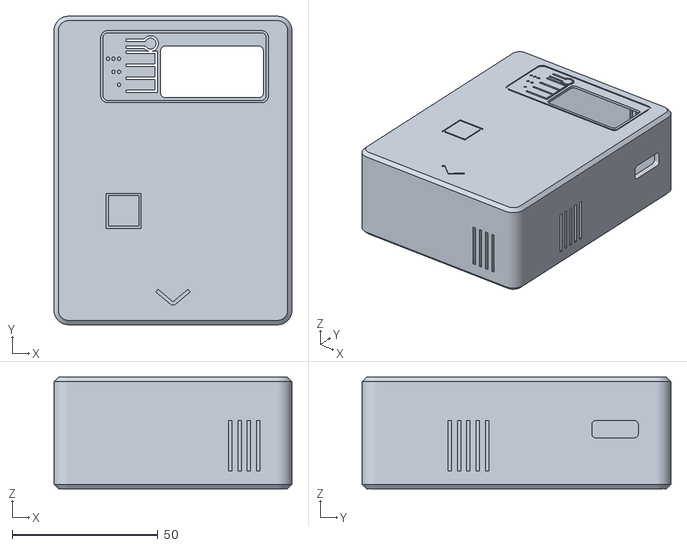
[picture p100: CAD file, 2026-10-18]
mechanical/output/shell.stl
81.6 x 105.8 x 38.3
