zredlined/esp32-race-logger-enclosure/(list of files, cad)

Other CAD files:
mechanical/display/output/print_bench_stand.stl
mechanical/display/output/print_backpack.stl
mechanical/display/output/depth_coupon.stl
mechanical/output/sled.3mf
mechanical/display/output/print_gopro_puck.stl
mechanical/display/output/backpack.stl
mechanical/output/sled.stl
