zredlined/esp32-race-logger-enclosure/docs/assembly/assembly_section_x.png

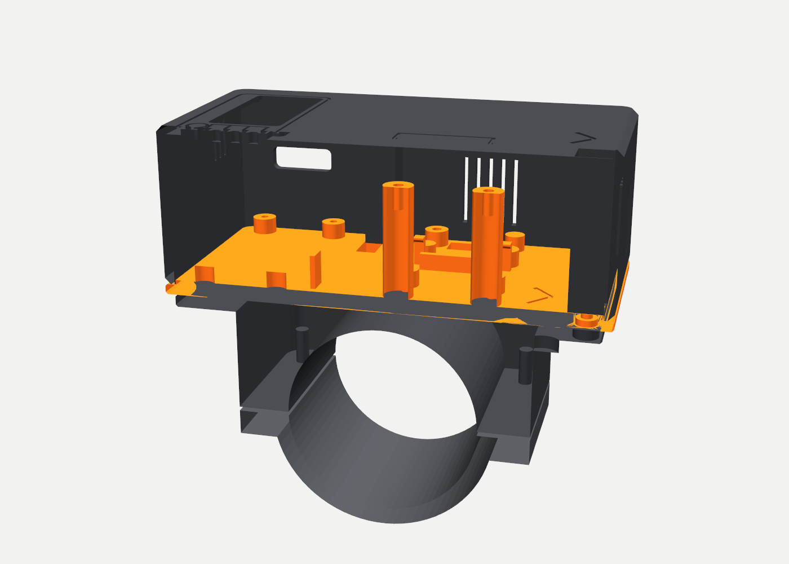
docs/assembly/assembly_section_x.png
