zredlined/esp32-race-logger-enclosure/docs/assembly/sled_imu_zoom.png

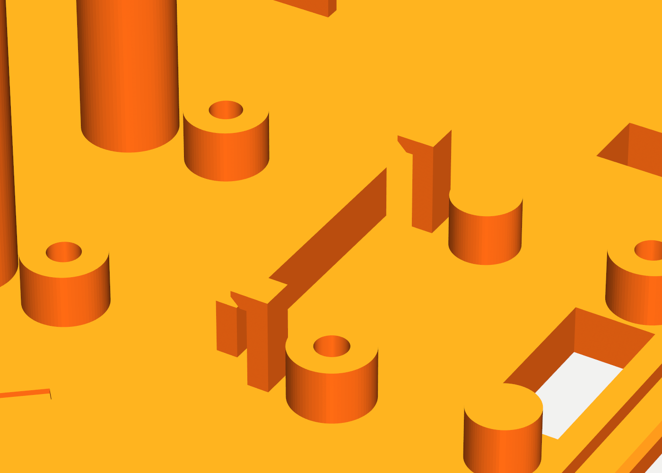
docs/assembly/sled_imu_zoom.png
