zredlined/esp32-race-logger-enclosure/docs/assembly/tray_step_zoom.png

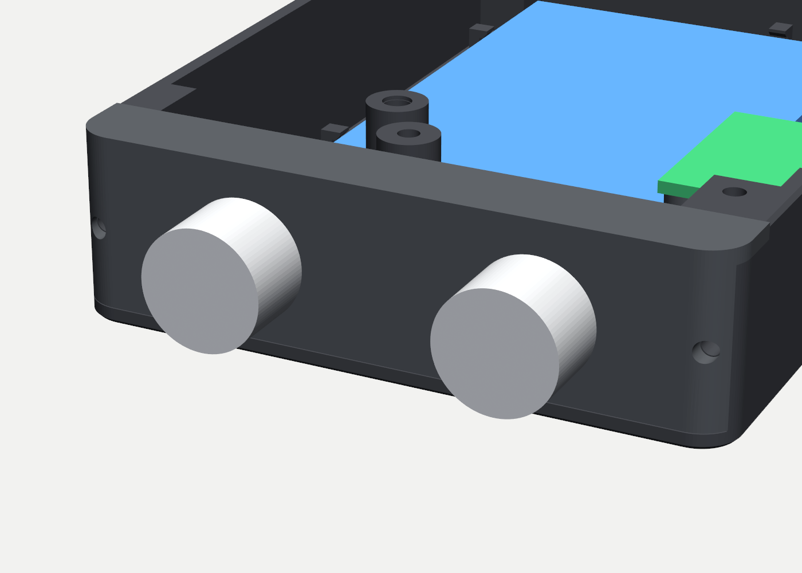
docs/assembly/tray_step_zoom.png
