zredlined/esp32-race-logger-enclosure/mechanical/output/renders/assembly_base_iso_low.png

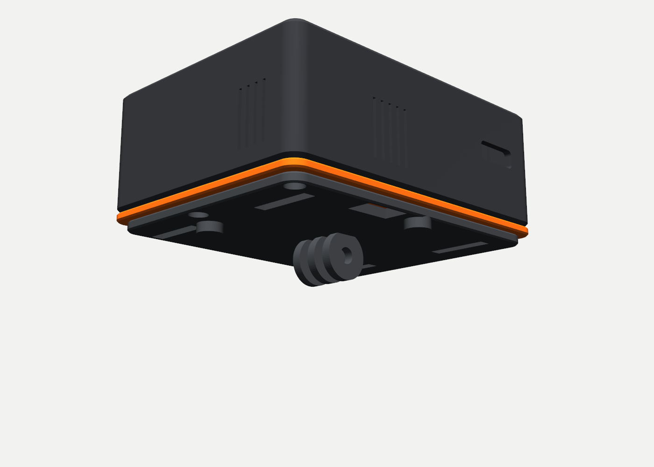
mechanical/output/renders/assembly_base_iso_low.png
