zredlined/esp32-race-logger-enclosure/mechanical/output/renders/assembly_exploded.png

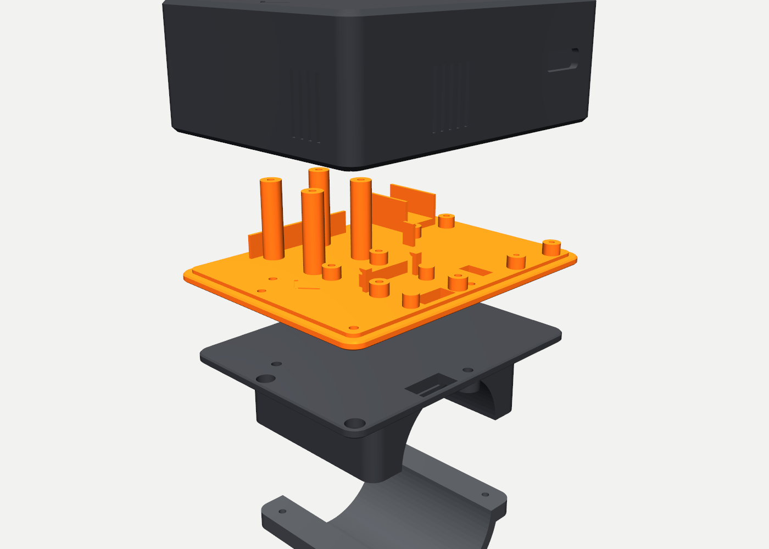
mechanical/output/renders/assembly_exploded.png
