zredlined/esp32-race-logger-enclosure/mechanical/output/renders/assembly_iso.png

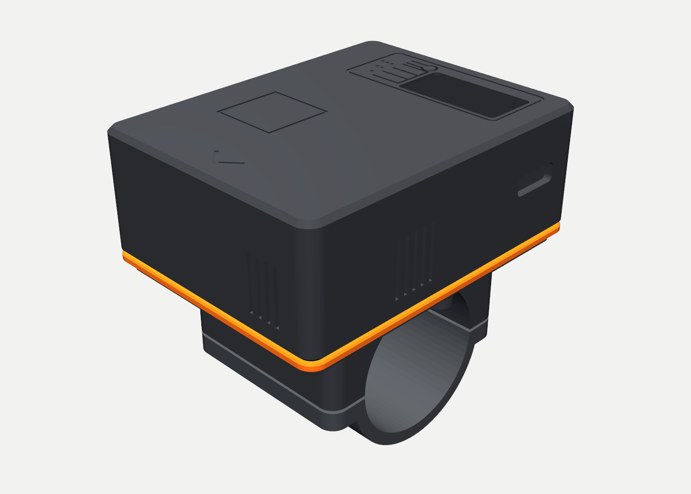
mechanical/output/renders/assembly_iso.png
