zredlined/esp32-race-logger-enclosure/mechanical/output/renders/assembly_iso_back.png

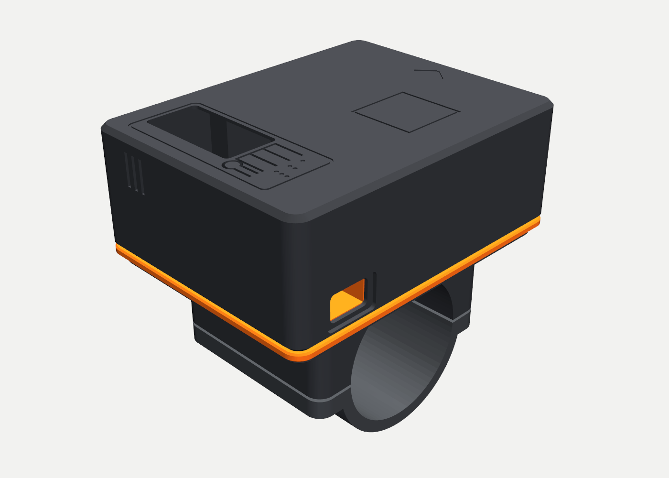
mechanical/output/renders/assembly_iso_back.png
