zredlined/esp32-race-logger-enclosure/mechanical/output/renders/assembly_section_y.png

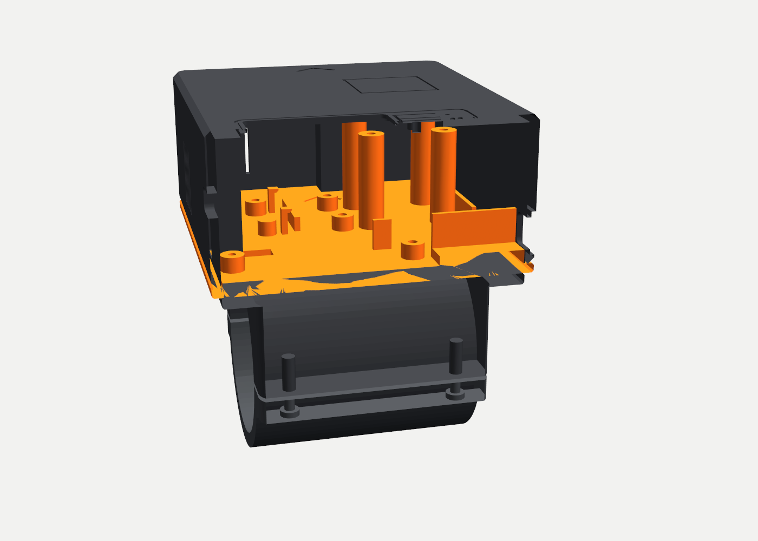
mechanical/output/renders/assembly_section_y.png
