zredlined/esp32-race-logger-enclosure/mechanical/output/renders/test_coupon_bottom.png

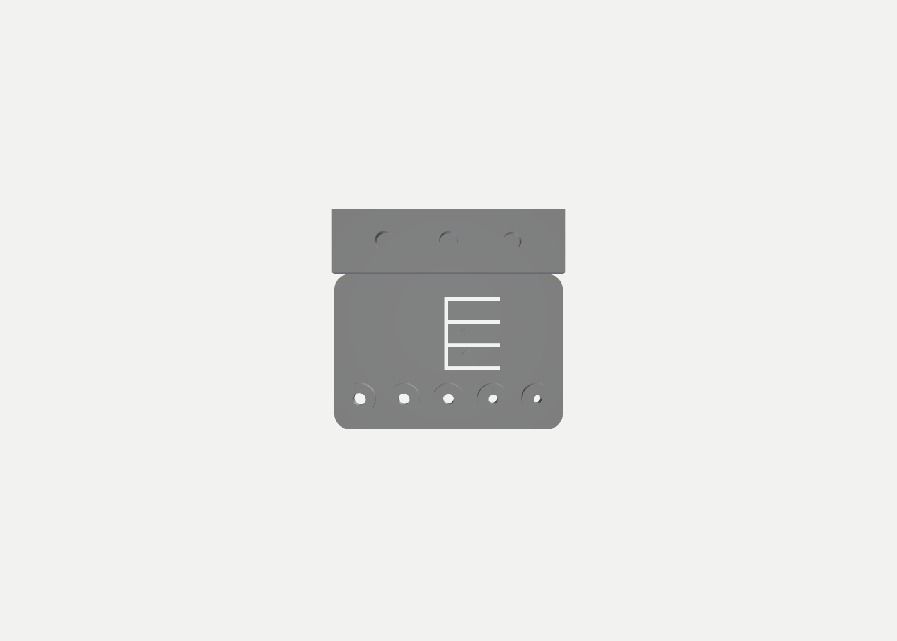
mechanical/output/renders/test_coupon_bottom.png
