zredlined/esp32-race-logger-enclosure/mechanical/output/renders/test_coupon_top.png

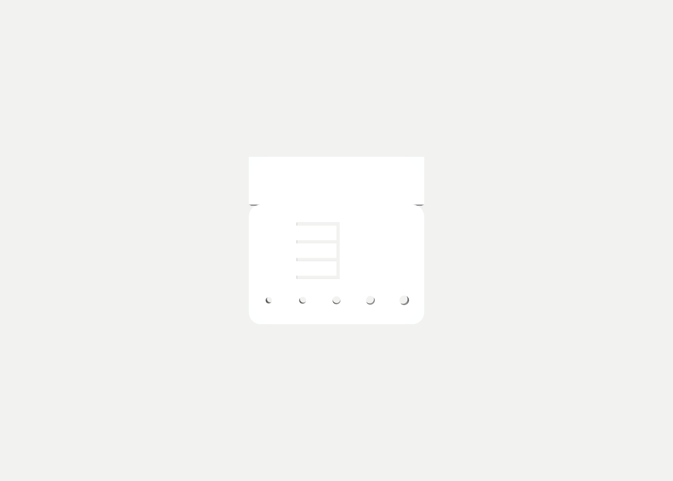
mechanical/output/renders/test_coupon_top.png
