zredlined/esp32-race-logger-enclosure/(commit log)

2026-10-18 ESP32 race logger enclosure: generator, docs, STLs, renders
    Generated Onshape enclosure for the Feather-based race logger: v1 shell + sled +
    GoPro base as printed, the parametric roll-bar saddle and cap, and the v2 analog
    tray (two ADS1115s, half-size perma-proto, connector card). Includes the build
    guide, BOM, concept study and inspection log, the Adafruit board files the layout
    derives from, exported STLs and renders, and the sibling display-mount project.
2026-10-18 README: link the 4OGSDash firmware repo, add the display mount section
2026-10-18 Split the display mount into its own repo; add the MIT license
    The Waveshare 7B display mount now lives at zredlined/waveshare-7b-race-display-mount.
    This repo keeps the logger enclosure only and links to the mount and the firmware.
